JB153486/Proyecto-Balanc-n-Inteligente-II/CAD/3D/electronic/ep32 rar/6876939292.webp

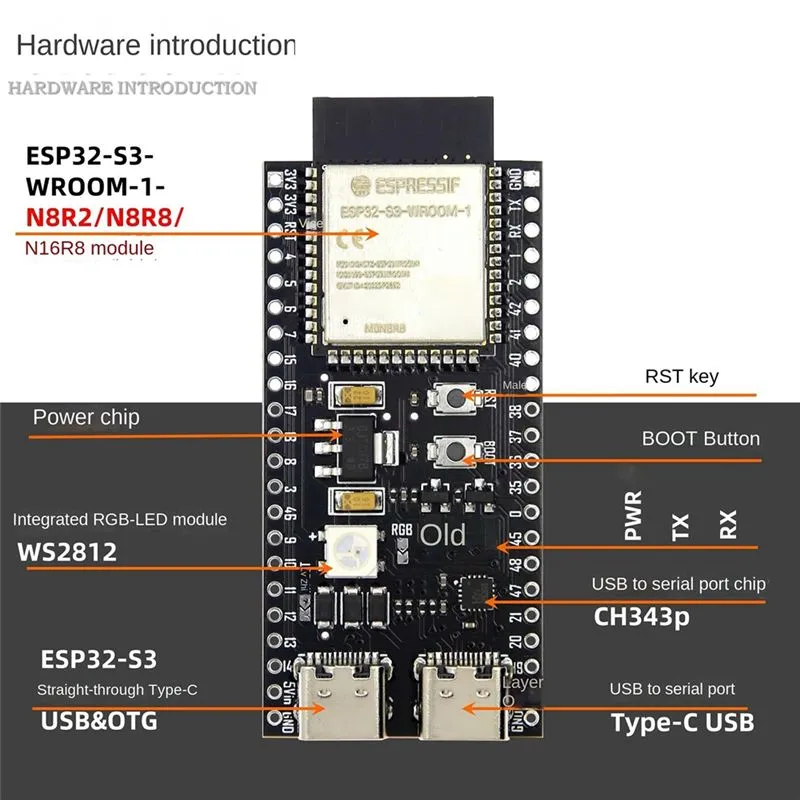
CAD/3D/electronic/ep32 rar/6876939292.webp
