JB153486/Proyecto-Balanc-n-Inteligente-II/Informe_RobotBalancin.docx

GUÍA DE PROYECTO:

DISEÑO, CONSTRUCCIÓN Y CONTROL DE UN PROTOTIPO AUTÓNOMO DE EQUILIBRIO DINÁMICO PARA SEGUIMIENTO DE TRAYECTORIA (“ROBOT SEGUIDOR BALANCÍN”)

Fase de Diseño, Construcción y Control de Equilibrio (Corte 1)

Grupo:

Rickson Alexis Hernández Jaime – 1092336882

José Daniel Barroeta Gámez – 141769323

Elkin Fabián Melo Rodríguez- 1093590111

Erley Yesid Guevara Maldonado -1092338859

Adriana Liney Florez Contreras - 1005000225

Docente:

Ing. Jeisson Martínez Flórez

Asignatura: Control Inteligente Cód. 168205

Universidad de Pamplona Facultad de Ingenierías y Arquitectura Programa de Ingeniería Mecatrónica

Villa del Rosario

TABLA DE CONTENIDO

# 1. ESPECIFICACIÓN GENERAL DEL PROYECTO

## 1.1. Resumen

El proyecto consiste en el diseño, construcción y control de un robot balancín autónomo, capaz de conservar su equilibrio dinámico mientras sigue una trayectoria determinada. El prototipo está formado por una estructura fabricada mediante impresión 3D, dos motorreductores con encoders, un sensor MPU-6050 encargado de medir la inclinación en tiempo real y un controlador ESP32-S3, que procesa la información y utiliza una estrategia de control PID para mantener la estabilidad, regulando la velocidad de los motores mediante señales PWM. El objetivo principal es conseguir que el robot mantenga el equilibrio de manera autónoma y se desplace de forma estable, demostrando la aplicación de técnicas de control automático. Entre los principales retos del proyecto se encuentran la selección de motores y materiales adecuados según las limitaciones de tamaño y peso, la calibración del sensor MPU-6050 y el ajuste manual de las constantes del PID, lo cual requirió realizar diversas pruebas hasta alcanzar una respuesta estable y precisa.

## 1.2. Objetivos Específicos.

- Investigar la variedad de componentes electrónicos y mecánicos que se pueden implementar en el robot.
- Elegir los componentes más adecuados teniendo en cuenta su disponibilidad y características técnicas.
- Diseñar la estructura física del robot y su circuito eléctrico, respetando las dimensiones establecidas.
- Implementar y ajustar el sistema de control PID mediante pruebas sucesivas hasta obtener un funcionamiento estable.

## 1.3. Alcance y Limitaciones

De acuerdo al reglamento las dimensiones de dicho robot no deben superar los 20 cm x 20 cm x 20 cm por lo que a la hora de selección de componentes y diseño del robot deben adaptarse a dicho reglamento. Además de este su peso no debe superar a 1 kilogramos, por lo que se debe tener en cuenta los pesos de los motores, llantas, batería y cuerpo, ya que son los que contienen el peso más significativo por lo que se ha mantenido en estos rangos.

# 2. ANÁLISIS DEL SISTEMA DE CONTROL DE EQUILIBRIO

Pregunta | Respuesta Detallada y Justificada
Objetivo de Control | Evitar que el robot pierda el equilibrio y caiga al suelo.
Variable Controlada | El robot controlara el ángulo de inclinación de esta misma y se estará midiendo en grados de inclinación de tal manera que el usuario pueda identificar mejor la varianza de esta.
Variable Manipulada | Para lograr el control del robot se manipulará la fuerza que ejercen cada uno de los motorreductores de acuerdo a la dirección de inclinación del robot enviándole señales en PWM.
Sensor | Se hará uso de un módulo MPU-6050 por su bajo costo y alta integración por su que combina en un solo chip un acelerómetro triaxial y un giroscopio triaxial.
Actuador | El efector final son unos Motorreductores de 12V y 100 rpm, teniendo así un buen torque para su control.
Controlador | En controlador que se estará usando es un módulo esp32 s3 N16R8, por su alto rendimiento y versatilidad, ya que integra un procesador dual-Core de 240 MHz, Wi-Fi y Bluetooth, y 16 MB de flash con 8 MB de PSRAM
Alimentación / Energía | Se utilizará una batería Litio 18650, esto para alimentar directamente los motores y con un regulador de voltaje pueda bajar el voltaje para alimentar el resto de la placa.
Interfaz Humano Máquina | El robot será programado en lenguaje C con la interfaz de IDLE de Arduino, de esta manera aplicándole su calibración automática al iniciar y empezar a controlar.
Setpoint | El setpoint será asignado directamente de la programación con la interfaz de Arduino.
Error | Con el módulo MPU detectará su ángulo en tiempo real y está comparándola con el ángulo deseado ingresado en la programación.
Rango de Operación | Se desea que el robot opere en un rango de 25 a -25 grados logrando un control efectivo.
Estrategia de Control | La estrategia de control que se implementara es control PID por medio de una librería de Arduino que ya viene integrada.

# 3. DISEÑO

## 3.1. Simulación de balancín con sus pesos

Primeramente asignamos los pesos y las dimensiones visualizados en la Ilustración 1,Ilustración 2,Ilustración 3 que nuestro Balancín tendrá para seguir con su respectiva simulación y visualizar que ubicación tiene mejores resultados el cual se vera reflejado en la Ilustración 4

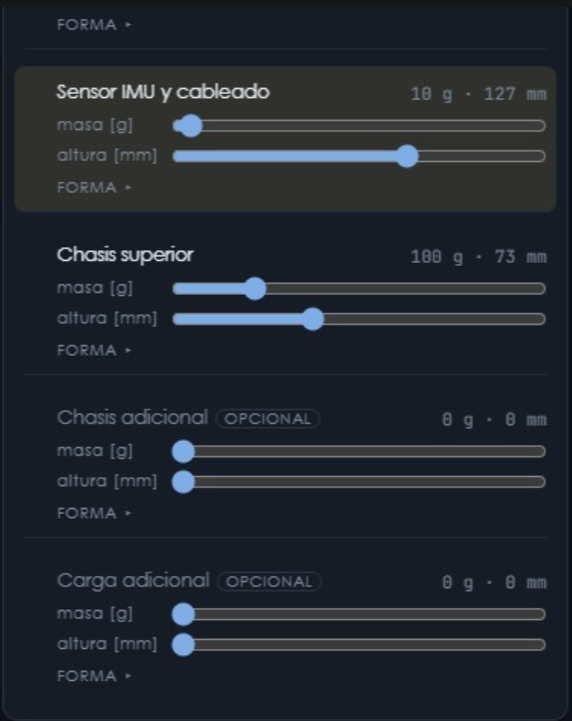
[picture p3: figure]

Ilustración 1 Simulación Dimensiones y peso Chasis

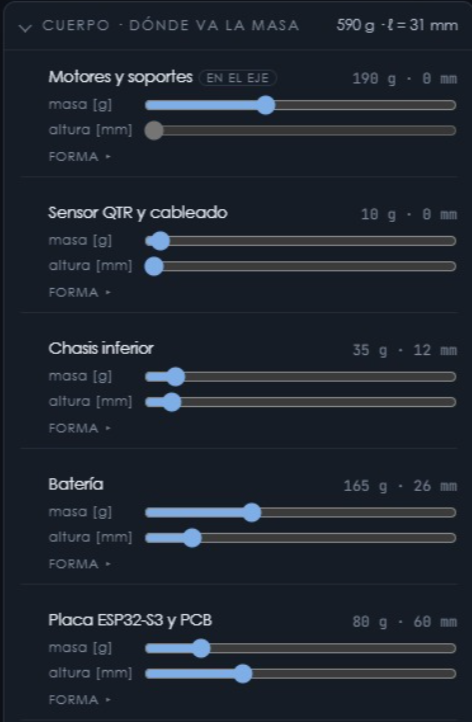
[picture p4: figure]

Ilustración 2 Simulación Cuerpo Balancín

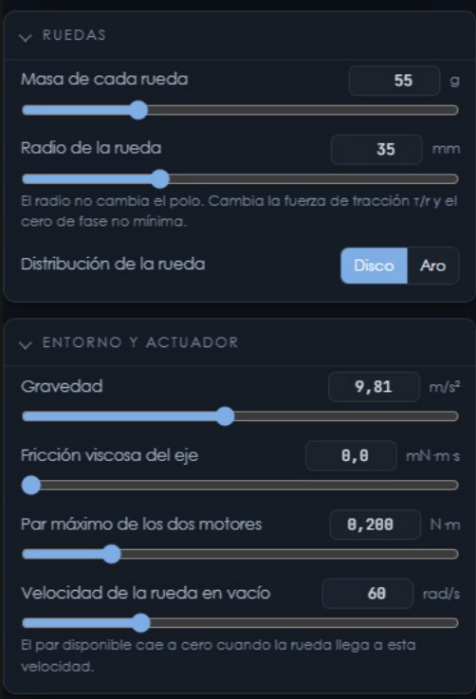
[picture p5: figure]

Ilustración 3 Simulacion zona inferior

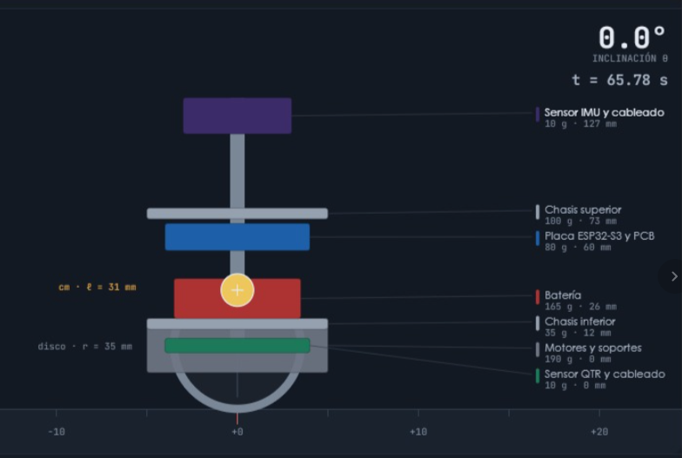
[picture p6: figure]

Ilustración 4 Visualización completa Balancín

Mayor información:

## 3.2. Diseño Mecánico CAD 3D

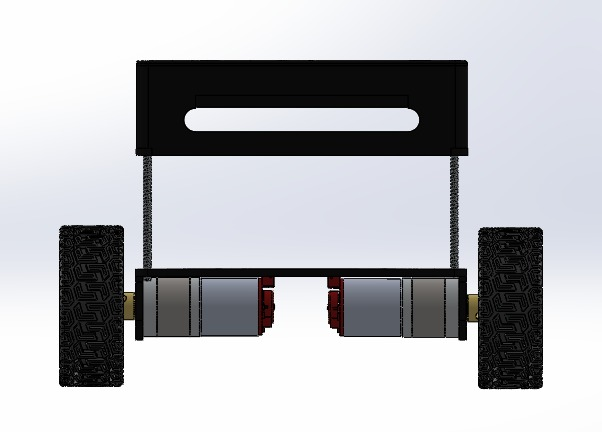
[picture p7: figure]

Ilustración 5 Ensamble del Robot

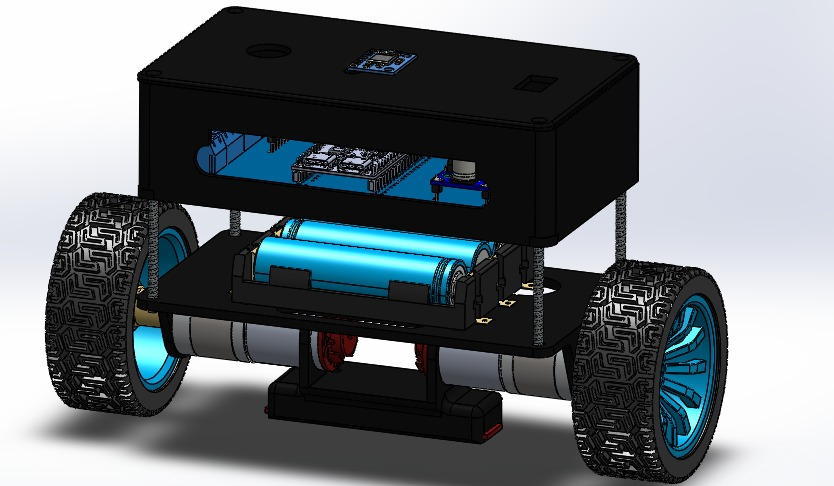
[picture p8: figure]

Ilustración 6 Diseño del robot balancín

La tapa del robot que se visualiza en la Ilustración 1 se pensó de tal manera que se instalara el MPU-6050 en todo el centro para obtener un buen rendimiento, la sección circular pensaba para agregarle un botón de inicio y la cuadrada un interruptor on/off.

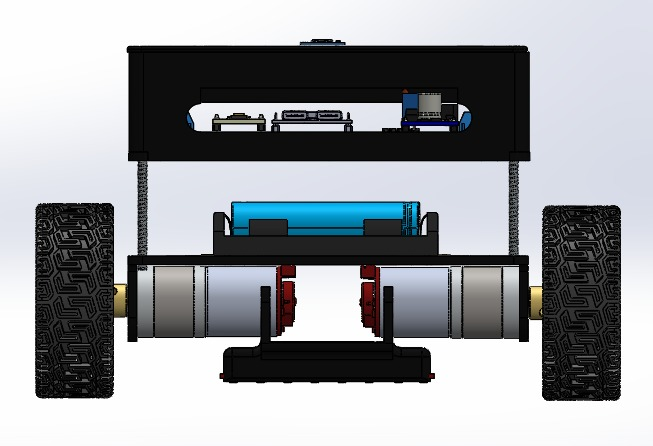
[picture p9: figure]

Ilustración 7 Visualización de las ubicaciones de componentes

En la Ilustración 3 Fue pensada para la ubicación de los módulos como el cerebro, que es la esp32, el regulador de voltaje, drivers y la placa donde ira conectada cada uno de estos módulos. La caja es pensada para que sin necesidad de extraer el esp32 pueda ser programada directamente.

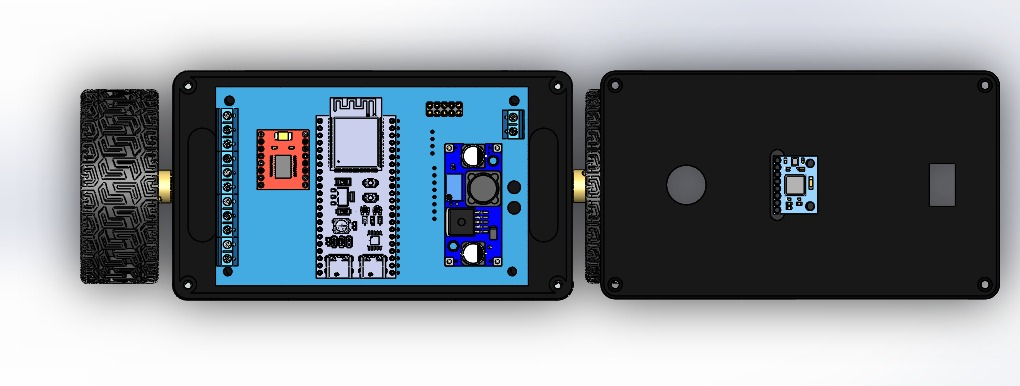
[picture p10: figure]

Ilustración 8 Parte superior

En la Ilustración 4 es pensada donde irán los implementos utilizados para este robot

Para mayor información revisa en el repositorio: https://github.com/JB153486/Proyecto-Balanc-n-Inteligente-II/tree/Rickson-Hernandez/PCB

## 3.3. Selección de Materiales

- Esp32 s3: Este controlador fue seleccionado por su alto rendimiento y versatilidad, ya que integra un procesador dual-Core de 240 MHz, Wi-Fi y Bluetooth, y 16 MB de flash con 8 MB de PSRAM, siendo esta más rápida que el Arduino Uno.

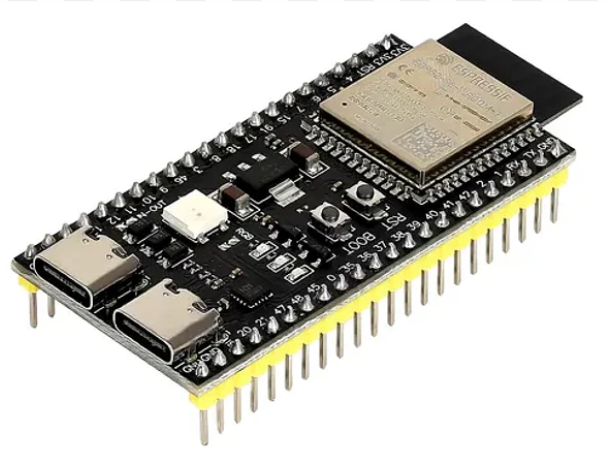
[picture p11: figure]

Motorreductor: 25GA370-12V-100RPM-ENCO es un motorreductor con encoder para generar un mayor control en el robot conociendo los pulsos generados por esta. Además, presentan un alto torque para un control más preciso.

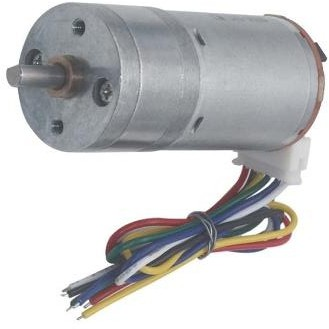
[picture p12: figure]

- Llanta de lujo: Fue seleccionado por su disponibilidad ya que esta fue adaptada con un accesorio impreso en 3D.

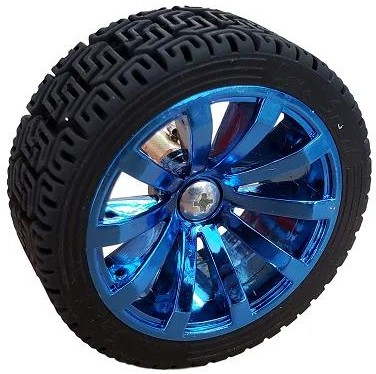
[picture p13: figure]

- Modulo MPU-6050: Este módulo se seleccionó por su bajo costo y alta integración que combina en un solo chip un acelerómetro triaxial y un giroscopio triaxial.

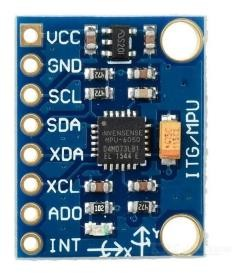
[picture p14: figure]
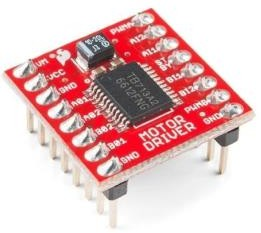
[picture p15: figure]

- TB6612FNG: Este driver tiene un pequeño tamaño y bajo costo por lo que es ideal para este diseño. Fue utilizados dos drivers para evitar sobrecalentamiento en momentos críticos.
- LM2596: Su selección es por su bajo costo y buena accesibilidad.

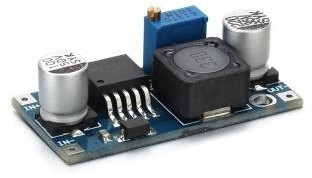
[picture p16: figure]

- Sensor seguidor de Línea 8 canales: Se selecciono por su disponibilidad.

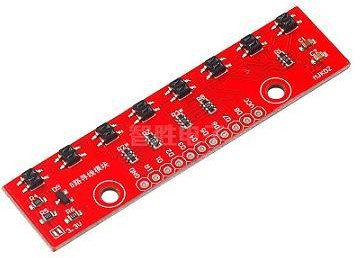
[picture p17: figure]

- PCB: Se recurrió realizar una Pcb ya que contine gran cantidad de conexiones y por el tamaño comparto del robot lo requiere.

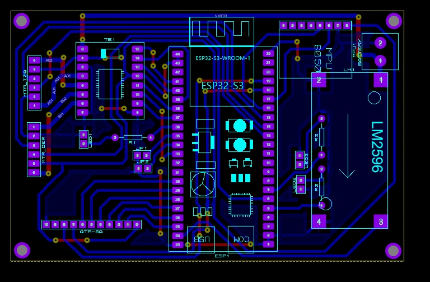
[picture p18: figure]
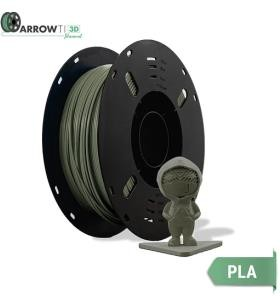
[picture p19: figure]

- PLA: Se utilizo este material ya que es ligero, cómodo y de buena durabilidad para este robot.

Otros accesorios:

- Bornes, Jumpers, conectores hembra, interruptor on/off, botón de inicio, conectores xt60, terminales, tornillos 3mm para su ensamble.

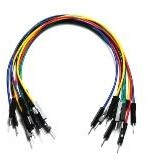
[picture p20: figure]
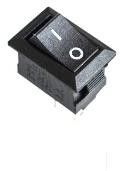
[picture p21: figure]
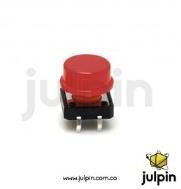
[picture p22: figure]
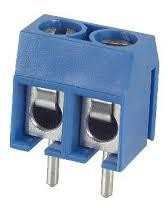
[picture p23: figure]

Puedes ver la data de cada uno aquí: https://github.com/JB153486/Proyecto-Balanc-n-Inteligente-II/tree/ElkinFabianMeloRodriguez/DATASHEETS

## 3.4. Esquema de Circuito Electrónico

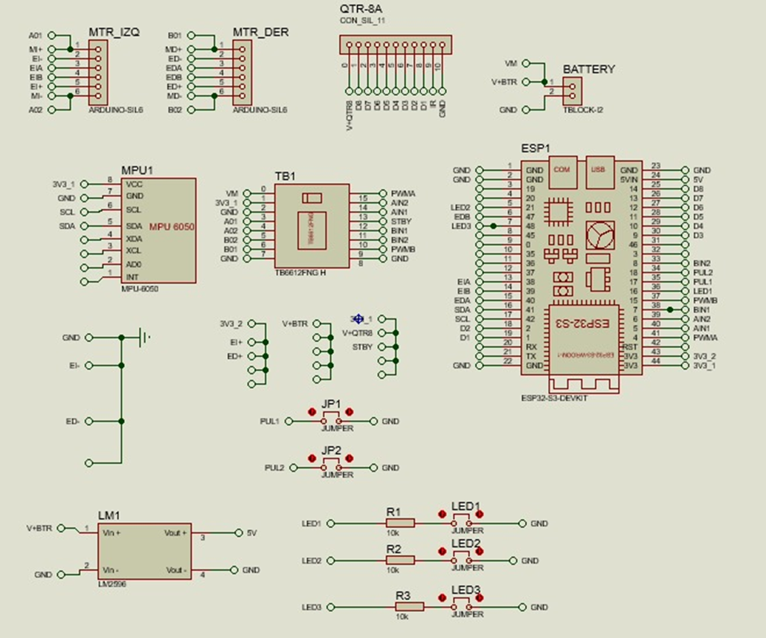
[picture p24: figure]

Ilustración 9 Circuito del robot

En la Ilustración 5 de presenta las conexiones con lo que se realizara la pcb ya que con esta ira conectada con todos los componentes del robot haciéndola más compacta.

Informacion completa de eeste en:

https://github.com/JB153486/Proyecto-Balanc-n-Inteligente-II/tree/Rickson-Hernandez/PCB

## 3.5. Estimación de costos

Componente/Material | Cantidad | Costo Unitario (COP) | Costo Total (COP)
Esp 32 S3 | 1 | $90.000 | $90.000
Motorreductor con encoder 12v 100rpm | 2 | $37.500 | $75.000
Llantas de lujo | 2 | $20.000 | $40.000
Modulo MPU-6050 | 1 | $18.000 | $18.000
Driver TB6612FNG | 2 | $15.000 | $15.000
Fuente suichieada variable LM2596 | 1 | $5.000 | $5.000
Sensor seguidor de línea-8 canales | 1 | $10.000 | $10.000
Bornera | 1 | $1.000 | $1.000
tornilleria | 16 | $400-1000 | $6.000
jumpers | 20 | $20 | $4.000
Plaqueta de cobre | 1 | $30.000 | $30.000
Impresión 3D | | $74.000 | $74.000
Costo de transporte | 1 | $10.000 | $10.000
Total | | | $378.000

# 4. CONSTRUCCIÓN

"En primer lugar, se llevó a cabo una investigación exhaustiva de los componentes aptos para este tipo de plataformas robóticas. Este proceso se apoyó en material audiovisual, literatura web y herramientas de inteligencia artificial con el fin de evaluar alternativas viables en función de su disponibilidad, costo y compatibilidad técnica.

Ya con esto se hizo la compra de los componentes necesarios a utilizar, se hizo su respectivo diseño en cad 3d, se hizo las conexiones necesarias en proteus y se empezó a diseñar en físico y a hacer las pruebas unitarias de este.

Después de dicha selección gracias al conocimiento adquirido de los videos se recurrió a realizar el diseño base del robot en el que se inspiró en la Ilustración 6, quedando un resultado como se logra visualizar en la Ilustración 7 .

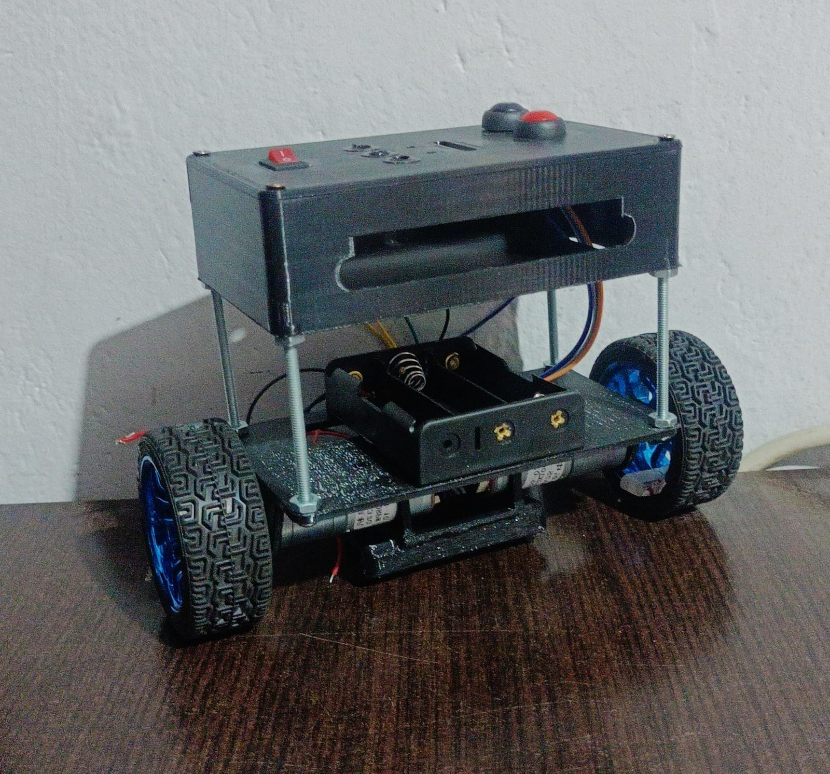
[picture p25: figure]

Ilustración 10 Robot Balancín

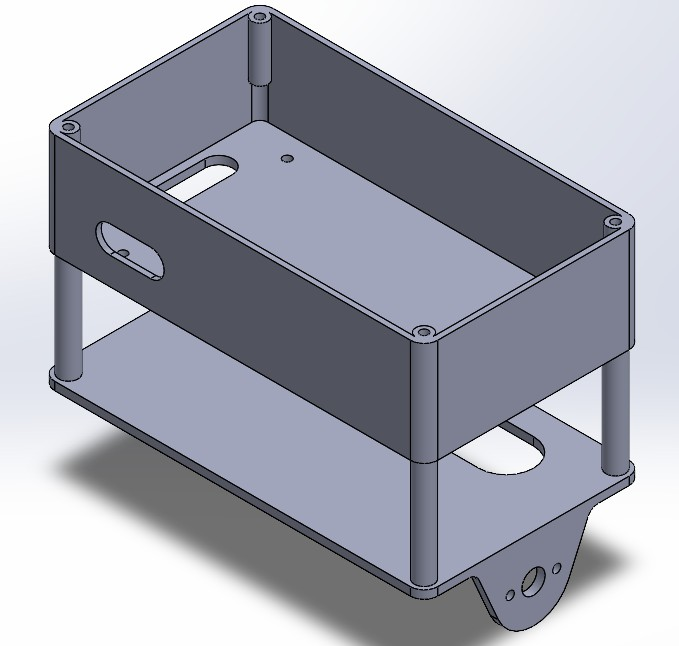
[picture p26: figure]

Ilustración 11 Diseño 3D pieza

En un principio se pensó Hacer la impresión en una sola pieza, pero se encontraba el problema que por el tamaño del robot a la hora de imprimir dificultaba a la impresora 3D y se gastaría material innecesario en soportes para su impresión. Entonces para más practicidad se decidió dividir en dos partes el diseño y conectarlas con tornillos de 4mm se son sencillos de conseguir, ya que al querer conseguir tornillos de expansión no había disponibilidad en la ciudad y el costo de importación no se justificaba.

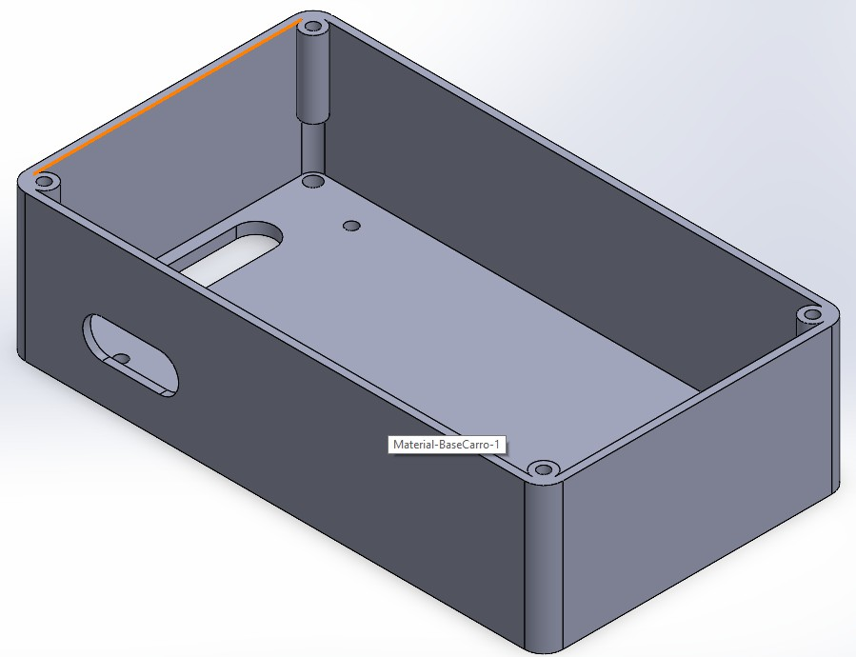
[picture p27: figure]

Ilustración 12 Pieza 1 del diseño del Robot

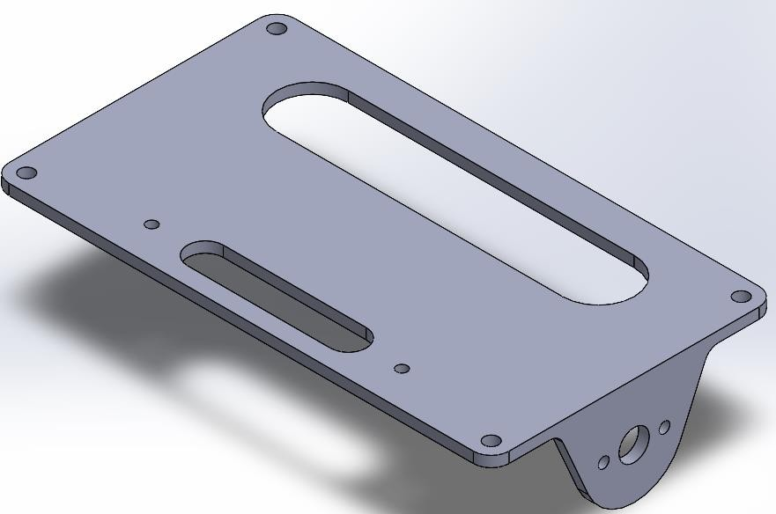
[picture p28: figure]

Ilustración 13 Pieza 2 del diseño del Robot

También se realizó el diseño de la tapa donde irían ubicado el MPU-6050 y los botones.

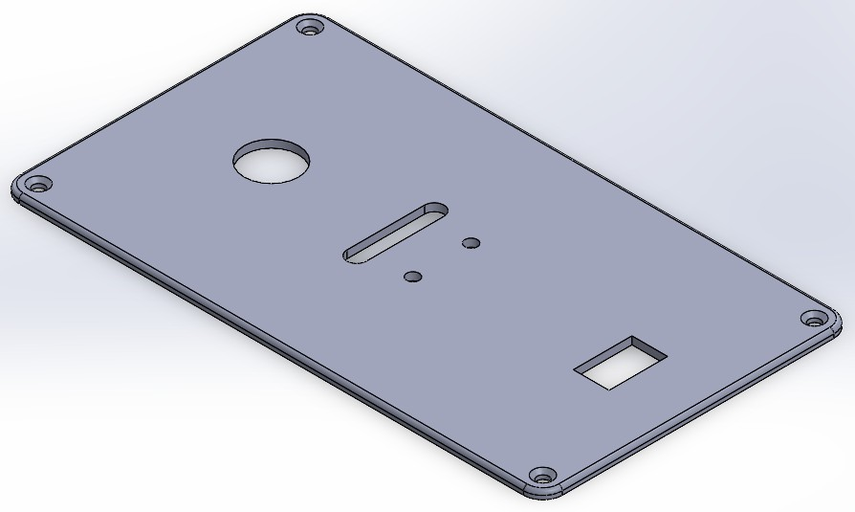
[picture p29: figure]

Ilustración 14 Tapa del Robot

Teniendo el Diseño ya establecido y con la llegada de los componentes como siguiente paso se realizó pruebas independientes tanto al MPU-6050 y el Driver TB6612FNG como se logra visualizar en la Ilustración 11 e Ilustración 12

Informacion comleta en: https://github.com/JB153486/Proyecto-Balanc-n-Inteligente-II/tree/Rickson-Hernandez/PCB

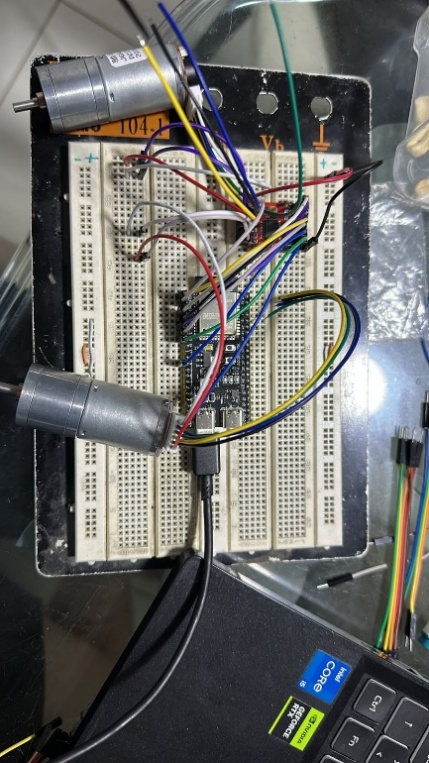
[picture p30: figure]

Ilustración 15 Pruebas unitarias en motores encoders

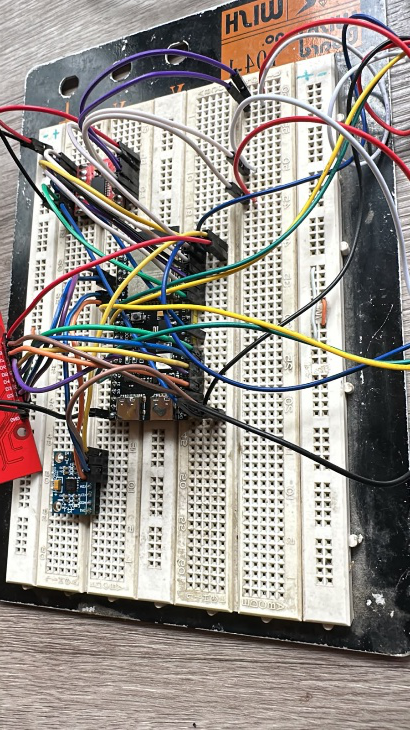
[picture p31: figure]

Ilustración 16 Pruebas unitarias en puente H, MPU y sensor de línea

Ya comprobando el funcionamiento de los componentes recurrimos a realizar la programación integrando las librerías del PID para realizar su primera prueba en protoboard y así diseñar su PCB.

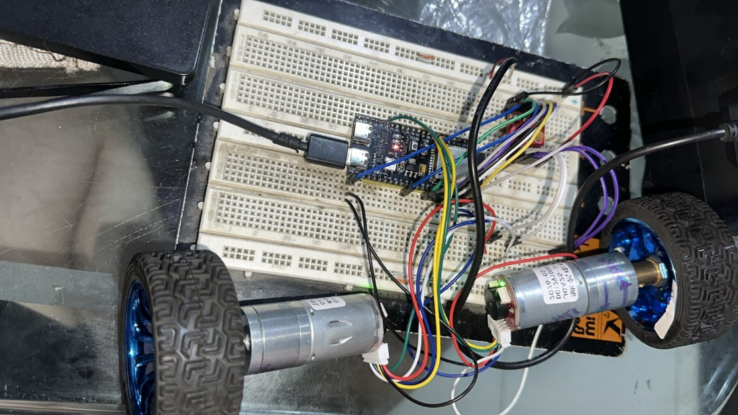
[picture p32: figure]

Ilustración 17 Prueba de conexión con Programación PID

Informacion completa de las pruebas:

https://github.com/JB153486/Proyecto-Balanc-n-Inteligente-II/tree/ElkinFabianMeloRodriguez/PruebasUnitarias

Por otro lado, se realizó la construcción física del robot sin sus módulos para evaluar sus dimensiones y estética del robot dando un buen aspecto constructivo.

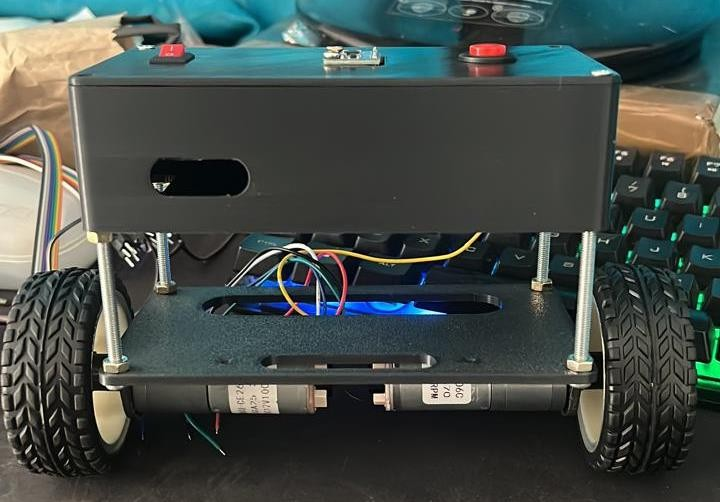
[picture p33: figure]

Ilustración 18 Ensamble físico del Robot

Como primera prueba del código dio una respuesta positiva, por lo que se recurrió a avanzar al siguiente paso que es el diseñado de la PCB iniciando suministrándoles sus conexiones incluyendo botones y borneras.

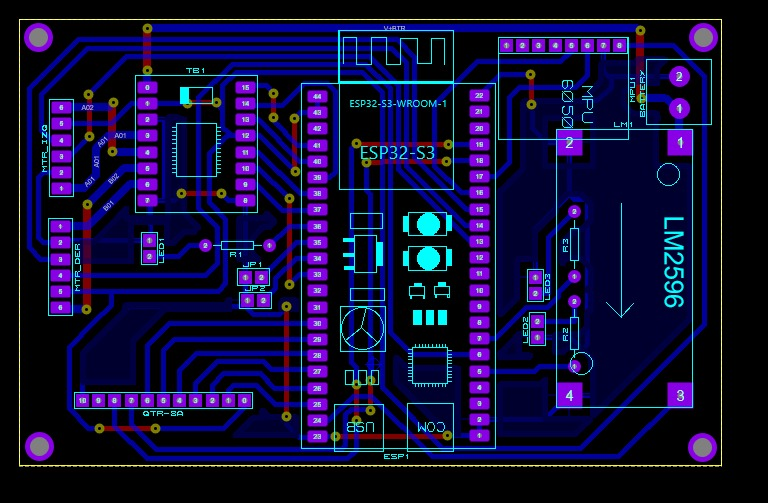
[picture p34: figure]

Ilustración 19 Diseño PCB en Proteus

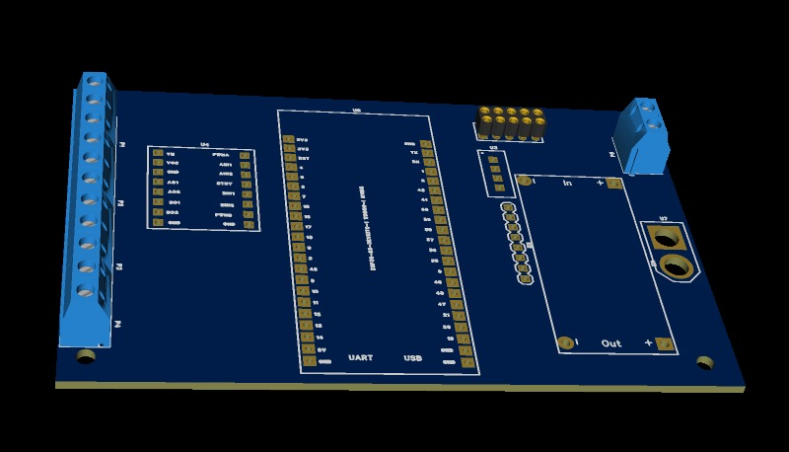
[picture p35: figure]

Ilustración 20 PCB simulada en 3D

Teniendo el deseño simulado en proteus y listo, procedemos a realizarlo en físico quedando de la siguiente manera

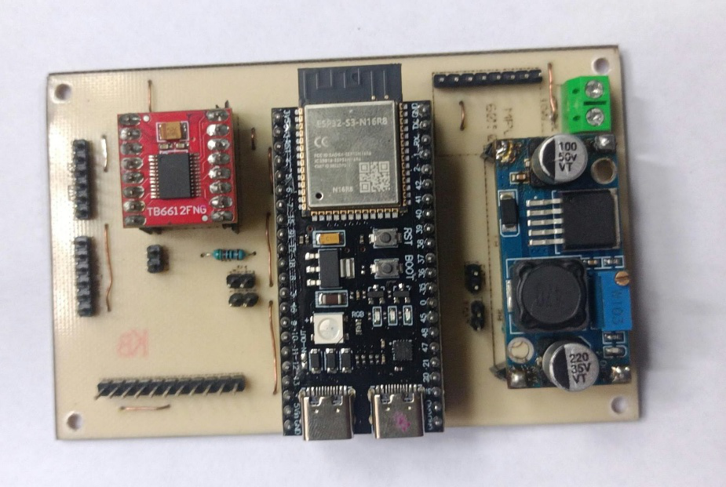
[picture p36: figure]

Ilustración 21 Placa Física del Robot

Informacion completa en: https://github.com/JB153486/Proyecto-Balanc-n-Inteligente-II/tree/Rickson-Hernandez/PCB

  4.1. Conexiones de cada componente

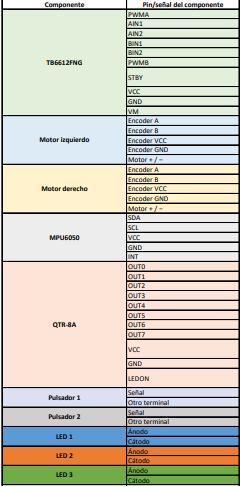
[picture p37: figure]
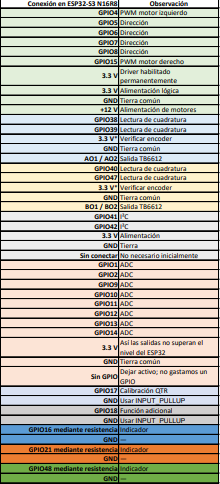
[picture p38: figure]

Ilustración 22 Conexiones componente a componente

En esta ilustración podemos encontrar las conexiones de cada componente en donde podemos encontrar el pin al que es conectado cada componente , las conexiones de la Esp32-s3 y tenemos una pequeña definición de que sería cada pin.

Mayor información: https://github.com/JB153486/Proyecto-Balanc-n-Inteligente-II/blob/ElkinFabianMeloRodriguez/CONEXIONES/Componente.pdf

# 5. PRUEBAS DE PROTOTIPO PARA EL EQUILIBRIO

Código pruebas equilibrio

// ============================================================

// INTEGRACIÓN IMU + ENCODERS + MOTORES

// CONTROL DE EQUILIBRIO - PASO 3: PD DE ÁNGULO (RUEDAS AL AIRE)

// ============================================================

#include "imu.h"

#include "encoders.h"

#include "motores.h"

#include "equilibrio.h"

#include "wifi_manager.h"

#include "telemetry.h"

#include "comandos.h"

#include "web_server.h"

// ============================================================

// PINES DE BOTONES Y LEDS (Según conection.xlsx)

// ============================================================

const int BOTON_QTR = 17; // Pulsador 1 (Calibración QTR)

const int BOTON_INICIO = 18; // Pulsador 2 (Iniciar balanceo y vel)

const int LED_POWER = 16; // LED 1 (Encendido)

const int LED_ACTIVO = 21; // LED 2 (Robot balanceando)

const int LED_QTR = 48; // LED 3 (Futuro QTR)

unsigned long ultimoTiempoBtn1 = 0;

unsigned long ultimoTiempoBtn2 = 0;

bool estadoAnteriorBtn1 = HIGH;

bool estadoAnteriorBtn2 = HIGH;

const unsigned long tiempoRebote = 200; // ms

// ============================================================

// TEMPORIZACIÓN DEL CONTROL

// ============================================================

// Periodo de control de 10 ms.

// Equivale a 100 Hz.

const unsigned long CONTROL_PERIOD_US = 10000;

// Tiempo de la última actualización.

unsigned long previousControlTime = 0;

// ---- BASELINE TEMPORAL (se quita después) ----

uint32_t bsT0 = 0, bsTicks = 0, bsLoops = 0;

float bsSum = 0, bsMin = 1e9f, bsMax = 0;

// ============================================================

// PARÁMETROS DE SEGURIDAD Y MOTORES

// ============================================================

// Si el robot supera este ángulo, los motores se cortan.

// Con las ruedas al aire usamos 60 grados.

// En el piso lo bajaremos a unos 30-35 grados.

const float ANGULO_CORTE = 50.0;

// Zona muerta de cada motor (PWM mínimo medido + pequeño margen).

const int ZM_L = 12; // izquierdo (medido 10-11)

const int ZM_R = 12; // derecho (medido 9-10)

// Los motores arrancan desarmados.

// Se arman por Serial con el comando e1.

bool habilitado = false;

unsigned long armandoHasta = 0; // 0 = sin cuenta regresiva

// ---- PI DE VELOCIDAD (lazo externo) ----

// (velKp, velKi, velIntegral, velDeseada y velActivo ahora están en comandos.h)

const float RADIO_RUEDA = 0.035f; // m

const float OFFSET_MAX = 20.0f; // grados máximos que puede mover el setpoint

float velKp = 42.0f;

// ============================================================

// COMPENSACIÓN DE ZONA MUERTA

// ============================================================

// Convierte la salida del controlador u (rango +-EQUILIBRIO_OUTPUT_LIMIT)

// en un PWM que ya supera la zona muerta del motor.

int compensarZonaMuerta(float u, int zm)

{

if (fabsf(u) < 0.5f)

{

return 0;

}

float mag = zm + (fabsf(u) / EQUILIBRIO_OUTPUT_LIMIT) * (255 - zm);

return (u > 0) ? (int)mag : -(int)mag;

}

// ============================================================

// COMANDOS POR SERIAL

//

// p10 -> Kp = 10

// d0.3 -> Kd = 0.3

// i0 -> Ki = 0

// t0.8 -> setpoint (punto de equilibrio) = 0.8 grados

// e1 -> armar motores

// e0 -> parar motores

//

// El Monitor Serial debe enviar "Nueva línea" o "Ambos NL & CR".

// ============================================================

void enviarRespuesta(uint32_t id, bool ok, const char *msg)

{

if (!colaResp || !telClientes) return;

Respuesta r = { id, (uint8_t)ok, "", equilibrioKp, equilibrioKi, equilibrioKd, equilibrioSetpoint,

velKp, velKi, velDeseada, (uint8_t)velActivo };

strncpy(r.msg, msg, sizeof(r.msg) - 1);

xQueueSend(colaResp, &r, 0);

}

void procesarComandos()

{

// 1) La parada de emergencia tiene prioridad sobre todo.

if (paroSolicitado)

{

habilitado = false;

armandoHasta = 0;

motoresStop();

equilibrioReset();

paroSolicitado = false;

enviarRespuesta(paroId, true, "");

}

// 2) Resto de comandos: este es el único lugar que escribe las variables.

Comando c;

while (colaCmd && xQueueReceive(colaCmd, &c, 0) == pdTRUE)

{

if (c.tipo == CMD_PARAMS)

{

equilibrioKp = c.kp; equilibrioKi = c.ki;

equilibrioKd = c.kd; equilibrioSetpoint = c.sp;

enviarRespuesta(c.id, true, "");

}

else if (c.tipo == CMD_VEL) // <-- NUEVA

{

velKp = c.vkp; velKi = c.vki;

if (c.vact && !velActivo) velIntegral = 0;

velActivo = c.vact;

velDeseada = (c.vact && habilitado) ? c.vref : 0;

enviarRespuesta(c.id, true, "");

}

else if (!c.on)

{

habilitado = false;

armandoHasta = 0;

motoresStop();

equilibrioReset();

enviarRespuesta(c.id, true, "");

}

else if (fabsf(imuGetAngleRobot()) >= ANGULO_CORTE)

{

enviarRespuesta(c.id, false, "Inclinacion excesiva");

}

else

{

armandoHasta = millis() + ARM_ESPERA_MS;

enviarRespuesta(c.id, true, "");

}

}

// 3) Fin de la cuenta regresiva: arma solo si el robot sigue en rango.

if (armandoHasta && (long)(millis() - armandoHasta) >= 0)

{

armandoHasta = 0;

if (fabsf(imuGetAngleRobot()) < ANGULO_CORTE)

{

equilibrioReset();

habilitado = true;

}

}

}

void procesarSerial()

{

if (!Serial.available())

{

return;

}

char c = Serial.read();

if (c == '\n' || c == '\r' || c == ' ')

{

return;

}

float v = Serial.parseFloat();

switch (c)

{

case 'p': if (v >= 0 && v <= LIM_KP_MAX) equilibrioKp = v; break;

case 'd': if (v >= 0 && v <= LIM_KD_MAX) equilibrioKd = v; break;

case 'i': if (v >= 0 && v <= LIM_KI_MAX) equilibrioKi = v; break;

case 't': if (fabsf(v) <= LIM_SP_MAX) equilibrioSetpoint = v; break;

case 'v': if (v >= 0 && v <= LIM_VKP_MAX) velKp = v; break; // v4

case 'w': if (v >= 0 && v <= LIM_VKI_MAX) velKi = v; break; // w1

case 'r': if (fabsf(v) <= LIM_VREF_MAX && habilitado) velDeseada = v; break; // r0.2

case 'y': velActivo = (v != 0); velIntegral = 0; break; // y1 / y0

case 'e':

habilitado = (v != 0);

armandoHasta = 0;

equilibrioReset();

break;

}

if ((c == 'p' && (v < 0 || v > LIM_KP_MAX)) ||

(c == 'd' && (v < 0 || v > LIM_KD_MAX)) ||

(c == 'i' && (v < 0 || v > LIM_KI_MAX)) ||

(c == 't' && fabsf(v) > LIM_SP_MAX))

{

Serial.println("Valor fuera de rango: ignorado");

}

Serial.printf("Kp=%.2f Kd=%.2f Ki=%.2f Set=%.2f En=%d\n",

equilibrioKp, equilibrioKd, equilibrioKi,

equilibrioSetpoint, habilitado);

}

// ============================================================

// SETUP

// ============================================================

void setup()

{

// --------------------------------------------------------

// SERIAL

// --------------------------------------------------------

Serial.begin(115200);

// --- INICIALIZAR BOTONES Y LEDS ---

pinMode(BOTON_QTR, INPUT_PULLUP);

pinMode(BOTON_INICIO, INPUT_PULLUP);

pinMode(LED_POWER, OUTPUT);

pinMode(LED_ACTIVO, OUTPUT);

pinMode(LED_QTR, OUTPUT);

// Encender el LED de Power para indicar que la ESP32 inició

digitalWrite(LED_POWER, HIGH);

// Apagar los otros dos LEDs temporalmente

digitalWrite(LED_ACTIVO, LOW);

digitalWrite(LED_QTR, LOW);

// Evita que parseFloat() bloquee el lazo de control.

Serial.setTimeout(10);

// Esperamos al monitor serial.

delay(1500);

Serial.println();

Serial.println("======================================");

Serial.println(" INTEGRACION CONTROL EQUILIBRIO");

Serial.println("======================================");

// --------------------------------------------------------

// MOTORES

// --------------------------------------------------------

// Inicializamos el controlador de motores.

motoresBegin();

// Por seguridad, los dejamos detenidos.

motoresStop();

// --------------------------------------------------------

// ENCODERS

// --------------------------------------------------------

// Inicializamos los dos encoders.

setupEncoders();

// --------------------------------------------------------

// IMU

// --------------------------------------------------------

Serial.println("Inicializando MPU6050...");

// Inicializamos el IMU.

if (!imuBegin())

{

Serial.println("ERROR: MPU6050 no encontrado.");

// Si no existe IMU, detenemos el programa.

motoresStop();

while (true)

{

delay(1000);

}

}

// --------------------------------------------------------

// CALIBRACIÓN DEL GIROSCOPIO

// --------------------------------------------------------

Serial.println();

Serial.println("Mantener robot quieto.");

Serial.println("Iniciando calibracion...");

imuCalibrateGyro();

if (wifiBegin())

{

Serial.print("WiFi AP listo: ");

Serial.println(WiFi.softAPIP());

telemetriaInit();

comandosInit();

wsBegin();

}

else

{

Serial.println("ERROR: no se pudo iniciar el AP.");

}

// --------------------------------------------------------

// REINICIAR TEMPORIZACIÓN DEL IMU

// --------------------------------------------------------

imuResetTiming();

// --------------------------------------------------------

// CONTROL DE EQUILIBRIO

// --------------------------------------------------------

equilibrioBegin();

// --------------------------------------------------------

// TIEMPO DEL CONTROL

// --------------------------------------------------------

previousControlTime = micros();

bsT0 = millis();

Serial.println();

Serial.println("Sistema listo.");

Serial.println("Motores detenidos.");

Serial.println("Comandos: p<Kp> d<Kd> i<Ki> t<setpoint> e1/e0");

Serial.println();

}

void procesarBotones()

{

unsigned long tiempoActual = millis();

// Leemos cómo están los botones en este exacto milisegundo

bool estadoActualBtn2 = digitalRead(BOTON_INICIO);

bool estadoActualBtn1 = digitalRead(BOTON_QTR);

// 1) BOTÓN 2 (Inicio/Parada de Balanceo)

// Solo actúa si AHORA está presionado (LOW) y ANTES estaba suelto (HIGH)

if (estadoActualBtn2 == LOW && estadoAnteriorBtn2 == HIGH && (tiempoActual - ultimoTiempoBtn2 > tiempoRebote))

{

ultimoTiempoBtn2 = tiempoActual;

if (!habilitado) {

if (fabsf(imuGetAngleRobot()) < ANGULO_CORTE) {

equilibrioReset();

velIntegral = 0;

habilitado = true;

velActivo = true;

velDeseada = 0.0f;

Serial.println("▶ BOTON: Lazos ACTIVADOS");

} else {

Serial.println("⚠ BOTON: No se puede activar, el robot esta muy inclinado");

}

} else {

habilitado = false;

velActivo = false;

motoresStop();

equilibrioReset();

Serial.println("⏹ BOTON: Lazos DESACTIVADOS");

}

}

estadoAnteriorBtn2 = estadoActualBtn2; // Guardamos la foto del estado para el siguiente ciclo

// 2) BOTÓN 1 (Futura calibración de línea)

if (estadoActualBtn1 == LOW && estadoAnteriorBtn1 == HIGH && (tiempoActual - ultimoTiempoBtn1 > tiempoRebote))

{

ultimoTiempoBtn1 = tiempoActual;

digitalWrite(LED_QTR, !digitalRead(LED_QTR));

Serial.println("⚙ BOTON: Calibracion QTR presionado");

}

estadoAnteriorBtn1 = estadoActualBtn1;

// 3) ACTUALIZAR LEDS DE ESTADO

if (habilitado) {

digitalWrite(LED_ACTIVO, HIGH);

} else {

digitalWrite(LED_ACTIVO, LOW);

}

}

// ============================================================

// LOOP

// ============================================================

void loop()

{

bsLoops++;

// --------------------------------------------------------

// ACTUALIZAR IMU

// --------------------------------------------------------

imuUpdate();

// --------------------------------------------------------

// ACTUALIZAR ENCODERS

// --------------------------------------------------------

updateEncoders();

// --------------------------------------------------------

// COMANDOS POR SERIAL

// --------------------------------------------------------

procesarSerial();

procesarComandos();

procesarBotones(); // <--- AGREGA ESTA LÍNEA AQUÍ

// --------------------------------------------------------

// CONTROL A 100 Hz

// --------------------------------------------------------

unsigned long currentTime = micros();

unsigned long elapsedTime =

currentTime - previousControlTime;

if (elapsedTime >= CONTROL_PERIOD_US)

{

// Convertimos microsegundos a segundos.

float dt =

elapsedTime / 1000000.0;

// Guardamos el tiempo.

previousControlTime =

currentTime;

// ---- BASELINE TEMPORAL ----

float dtMs = dt * 1000.0f;

bsSum += dtMs; bsTicks++;

if (dtMs < bsMin) bsMin = dtMs;

if (dtMs > bsMax) bsMax = dtMs;

uint32_t ahora = millis();

if (ahora - bsT0 >= 2000) {

Serial.printf("BASE dt[ms] prom=%.2f min=%.2f max=%.2f ticks=%lu loop/s=%lu\n",

bsSum / bsTicks, bsMin, bsMax, (unsigned long)bsTicks,

(unsigned long)(bsLoops * 1000UL / (ahora - bsT0)));

bsSum = 0; bsTicks = 0; bsLoops = 0; bsMin = 1e9f; bsMax = 0; bsT0 = ahora;

}

/*

// ----------------------------------------------------

// ÁNGULO Y VELOCIDAD ANGULAR

// ----------------------------------------------------

float angulo = imuGetAngleRobot(); // grados

float velAng = imuGetGyroRateRobot(); // grados/s

// ---- PI DE VELOCIDAD ----

float vMedida = 0.5f * (getEncoderRadPerSecondFilteredLeft() +

getEncoderRadPerSecondFilteredRight()) * RADIO_RUEDA;

if (velActivo && habilitado)

{

float eV = velDeseada - vMedida;

velIntegral += eV * dt; // no acumula durante una caída

velIntegral = constrain(velIntegral, -OFFSET_MAX / max(velKi, 0.01f),

OFFSET_MAX / max(velKi, 0.01f));

equilibrioOffset = constrain(velKp * eV + velKi * velIntegral,

-OFFSET_MAX, OFFSET_MAX);

}

else

{

velIntegral = 0.0f;

equilibrioOffset = 0.0f;

if (!habilitado) velDeseada = 0.0f; // <-- NUEVA

}

*/

// ----------------------------------------------------

// ÁNGULO Y VELOCIDAD ANGULAR

// ----------------------------------------------------

float angulo = imuGetAngleRobot(); // grados

float velAng = imuGetGyroRateRobot(); // grados/s

// ---- CÁLCULO DE VELOCIDAD (100 Hz para telemetría) ----

float vMedida = 0.5f * (getEncoderRadPerSecondFilteredLeft() +

getEncoderRadPerSecondFilteredRight()) * RADIO_RUEDA;

// ---- PI DE VELOCIDAD (Aislado a 20 Hz) ----

static int contadorVelocidad = 0;

contadorVelocidad++;

if (contadorVelocidad >= 5)

{

contadorVelocidad = 0; // Reiniciamos el contador

if (velActivo && habilitado)

{

float eV = velDeseada - vMedida;

// dt para velocidad ahora es 5 veces mayor (0.05s)

float dt_vel = dt * 5.0f;

velIntegral += eV * dt_vel; // Integración corregida

velIntegral = constrain(velIntegral, -OFFSET_MAX / max(velKi, 0.01f),

OFFSET_MAX / max(velKi, 0.01f));

equilibrioOffset = constrain(velKp * eV + velKi * velIntegral,

-OFFSET_MAX, OFFSET_MAX);

}

else

{

velIntegral = 0.0f;

equilibrioOffset = 0.0f;

if (!habilitado) velDeseada = 0.0f;

}

}

// ----------------------------------------------------

// CONTROL DE EQUILIBRIO (PD)

// ----------------------------------------------------

float correccion =

equilibrioUpdate(angulo, velAng, dt);

// ----------------------------------------------------

// SIGNO

//

// error = setpoint - angulo, así que con el robot

// inclinado hacia adelante (angulo > 0) la corrección

// sale negativa. Las ruedas deben ir hacia adelante,

// por eso invertimos el signo.

// ----------------------------------------------------

float u = -correccion;

// ----------------------------------------------------

// ENVIAR A LOS MOTORES

// ----------------------------------------------------

if (habilitado && fabsf(angulo) < ANGULO_CORTE)

{

motoresSet(

compensarZonaMuerta(u, ZM_L),

compensarZonaMuerta(u, ZM_R));

}

else

{

motoresStop();

equilibrioReset();

// Si se cayó, queda desarmado hasta enviar e1.

if (fabsf(angulo) >= ANGULO_CORTE)

{

habilitado = false;

}

}

// ---- TELEMETRÍA ----

static float hzFiltrado = 95.0f;

hzFiltrado += 0.1f * ((1.0f / dt) - hzFiltrado);

if (telClientes)

{

long resta = armandoHasta ? (long)(armandoHasta - millis()) : 0;

MuestraTel tel = {

millis(), angulo, equilibrioSetpoint, (equilibrioSetpoint + equilibrioOffset) - angulo,

velAng, u,

(int16_t)motoresGetLeftPWM(), (int16_t)motoresGetRightPWM(),

getEncoderRPMFilteredLeft(), getEncoderRPMFilteredRight(),

hzFiltrado,

(uint8_t)(habilitado ? 1 : (armandoHasta ? 2 : 0)),

(uint8_t)(resta > 0 ? (resta + 999) / 1000 : 0) ,

vMedida, velDeseada, equilibrioOffset, (uint8_t)velActivo };

telemetriaPublicar(tel);

}

// ----------------------------------------------------

// MONITOR SERIAL

// ----------------------------------------------------

static uint8_t n = 0;

if (++n >= 5) // imprime cada 50 ms

{

n = 0;

Serial.printf("Robot:%.1f,U:%.0f,En:%d,V:%.2f,Off:%.2f\n",

angulo, u, habilitado, vMedida, equilibrioOffset);

}

}

}

Mayor información de cada función: https://github.com/JB153486/Proyecto-Balanc-n-Inteligente-II/tree/Jos%C3%A9-Barroeta/Control_Equilibrio/Control_Equilibrio

# 6. REFERENCIAS

https://category.yahboom.net/es/products/sbr-stm32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 (https://category.yahboom.net/es/products/sbr-stm32)

Inteligencia artificial como apoyo(chat gpt, Gemini) https://docs.arduino.cc/libraries/mpu6050/

https://www.automatizacionparatodos.com/puente-h-arduino/

https://docs.arduino.cc/libraries/pid/

Plantilla de Entrega Asignación Fase 1 (Corte 1) Control Inteligente 168205 2026-2 Código: FGA-XXXX Página 1 de 25

Plantilla de Entrega Asignación Fase 1 (Corte 1) Control Inteligente 168205 2025-2 Código: FGA-XXXX Página 17 de 25

Plantilla de Entrega Asignación Fase 1 (Corte 1) Control Inteligente 168205 2026-2 Código: FGA-XXXX Página 18 de 25

Plantilla de Entrega Asignación Fase 1 (Corte 1) Control Inteligente 168205 2026-2 Código: FGA-XXXX Página 25 de 25

Plantilla de Entrega Asignación Fase 1 (Corte 1) Control Inteligente 168205 2026-2 Código: FGA-XXXX Página 2 de 25

Plantilla de Entrega Asignación Fase 1 (Corte 1) Control Inteligente 168205 2026-2 Código: FGA-XXXX Página 3 de 25

Plantilla de Entrega Asignación Fase 1 (Corte 1) Control Inteligente 168205 2026-2 Código: FGA-XXXX Página 4 de 25

Plantilla de Entrega Asignación Fase 1 (Corte 1) Control Inteligente 168205 2026-2 Código: FGA-XXXX Página 5 de 25

Plantilla de Entrega Asignación Fase 1 (Corte 1) Control Inteligente 168205 2026-2 Código: FGA-XXXX Página 9 de 25

Plantilla de Entrega Asignación Fase 1 (Corte 1) Control Inteligente 168205 2026-2 Código: FGA-XXXX Página 10 de 25

Plantilla de Entrega Asignación Fase 1 (Corte 1) Control Inteligente 168205 2026-2 Código: FGA-XXXX Página 15 de 25

Plantilla de Entrega Asignación Fase 1 (Corte 1) Control Inteligente 168205 2026-2 Código: FGA-XXXX Página 16 de 25
