JB153486/Proyecto-Balanc-n-Inteligente-II/CAD/3D/electronic/ep32 rar/00.jpg

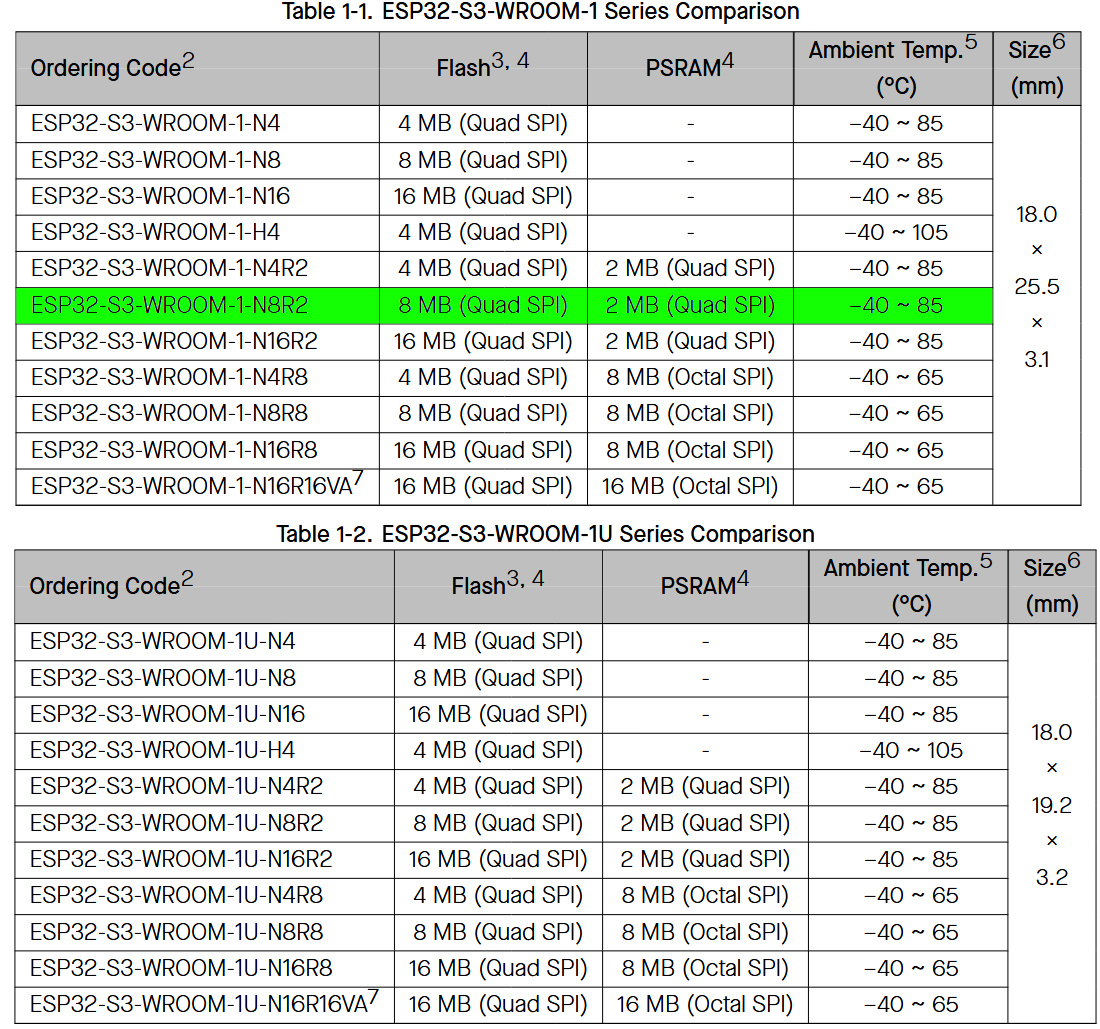
CAD/3D/electronic/ep32 rar/00.jpg
