JB153486/Proyecto-Balanc-n-Inteligente-II/CAD/3D/electronic/ep32 rar/6879005999.webp

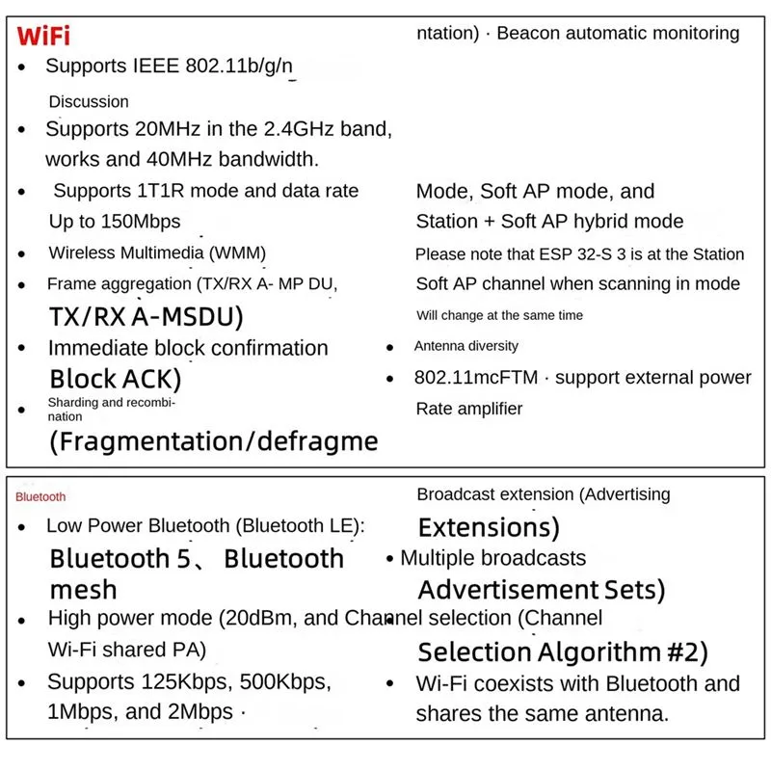
CAD/3D/electronic/ep32 rar/6879005999.webp
