JB153486/Proyecto-Balanc-n-Inteligente-II/CAD/3D/electronic/ep32 rar/ESP32-S3-WROOM-1-2.JPG

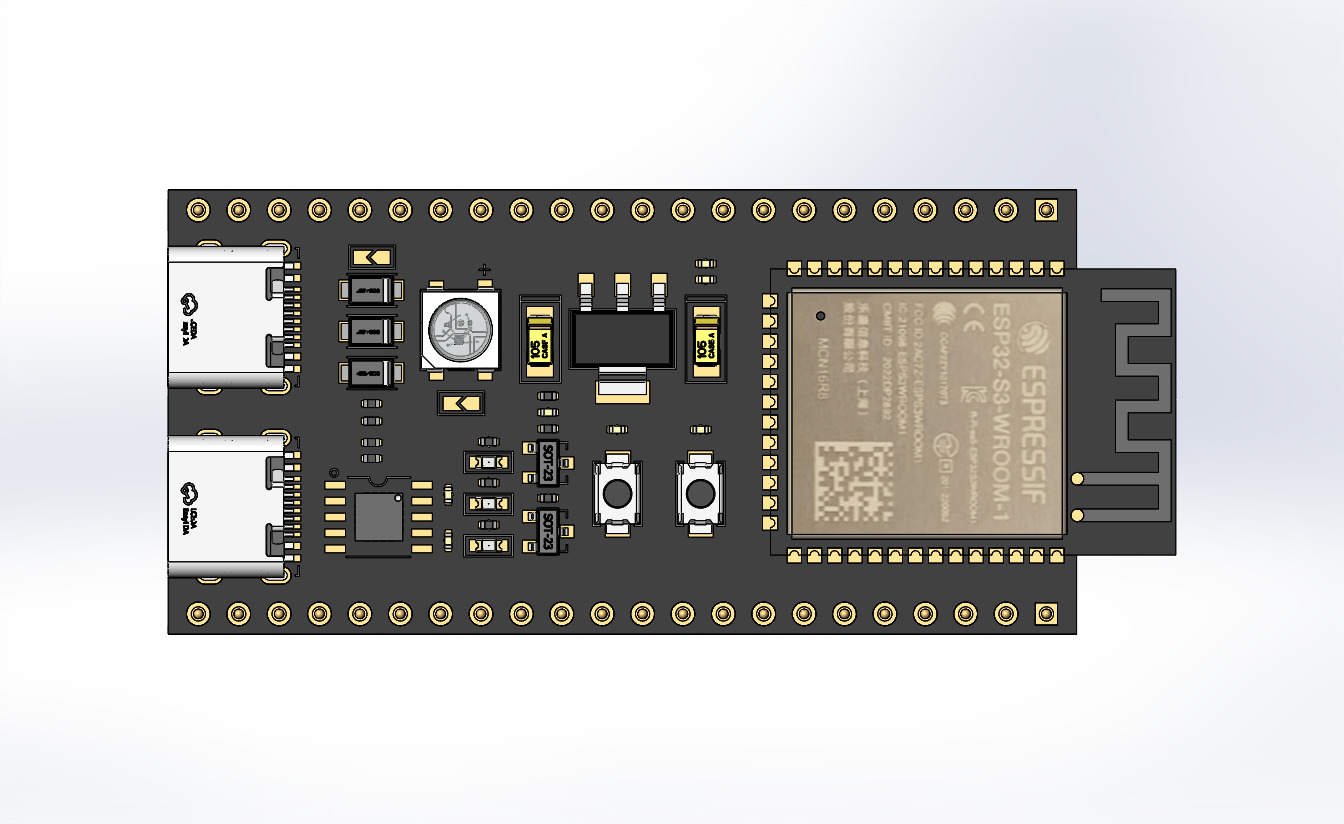
CAD/3D/electronic/ep32 rar/ESP32-S3-WROOM-1-2.JPG
