JB153486/Proyecto-Balanc-n-Inteligente-II/CAD/3D/electronic/ep32 rar/IMG_20260222_004332.png

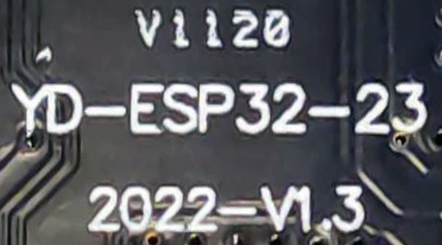
CAD/3D/electronic/ep32 rar/IMG_20260222_004332.png
