JB153486/Proyecto-Balanc-n-Inteligente-II/CAD/3D/electronic/lm5296/LM2596.png

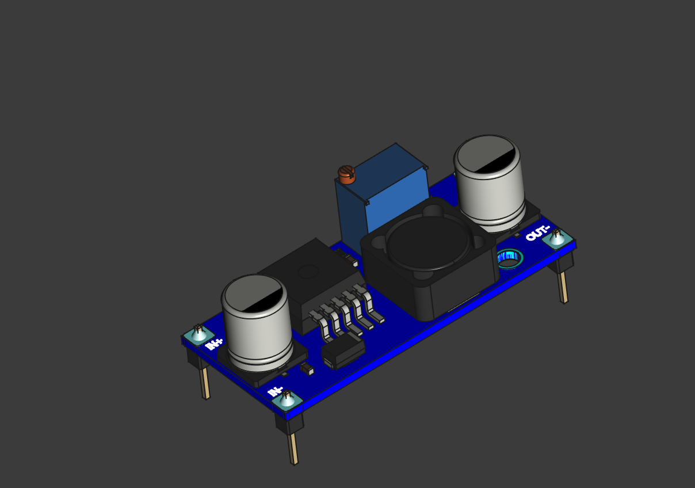
CAD/3D/electronic/lm5296/LM2596.png
