JB153486/Proyecto-Balanc-n-Inteligente-II/CAD/IMAGENES/Captura_1.PNG

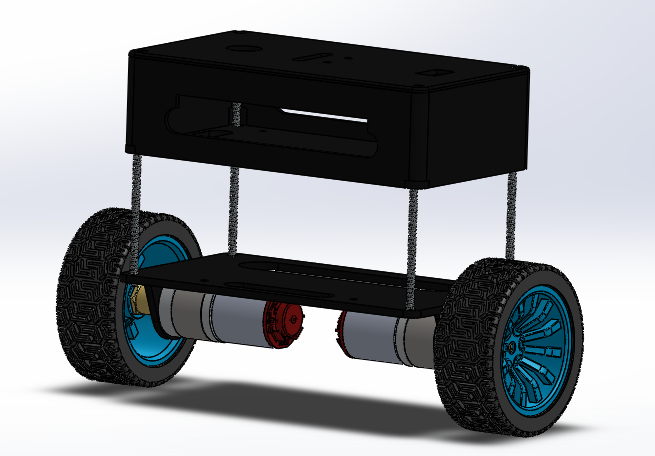
CAD/IMAGENES/Captura_1.PNG
