JB153486/Proyecto-Balanc-n-Inteligente-II/CAD/3D/electronic/tb6612fng/Solidworks 2022/TB6612FNG.SLDASM

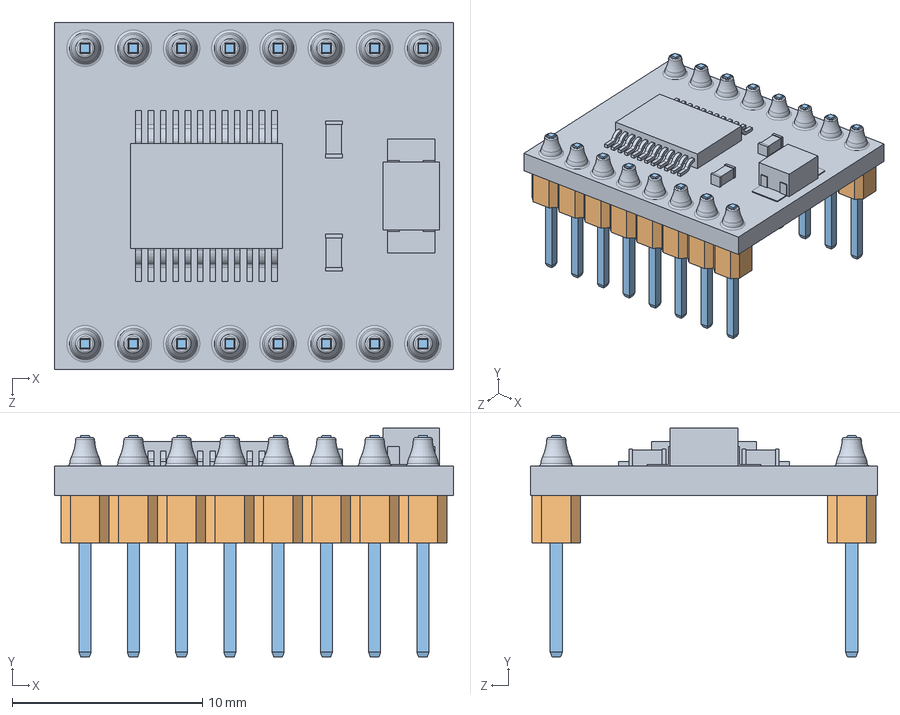
[picture p52: CAD file, 2026-09-23]
CAD/3D/electronic/tb6612fng/Solidworks 2022/TB6612FNG.SLDASM
21.0 x 12.1 x 18.2 mm
Base
Основание пина x 16
Пин x 16
