JB153486/Proyecto-Balanc-n-Inteligente-II/CAD/3D/bae_linea_qtr.SLDPRT

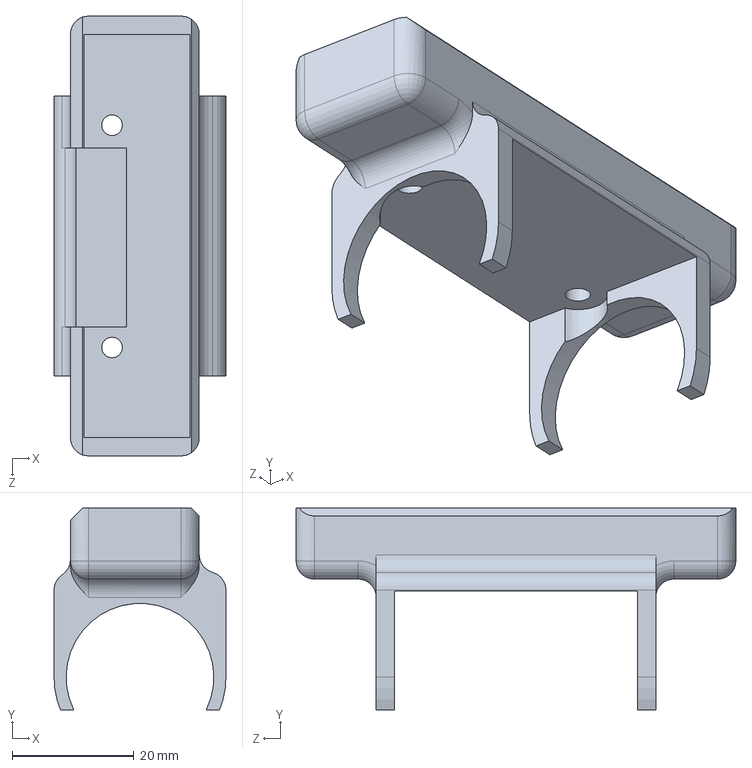
[picture p53: CAD file, 2026-09-23]
CAD/3D/bae_linea_qtr.SLDPRT
28.3 x 33.2 x 72.4 mm
