JB153486/Proyecto-Balanc-n-Inteligente-II/CAD/3D/electronic/lm5296/LM2596.step

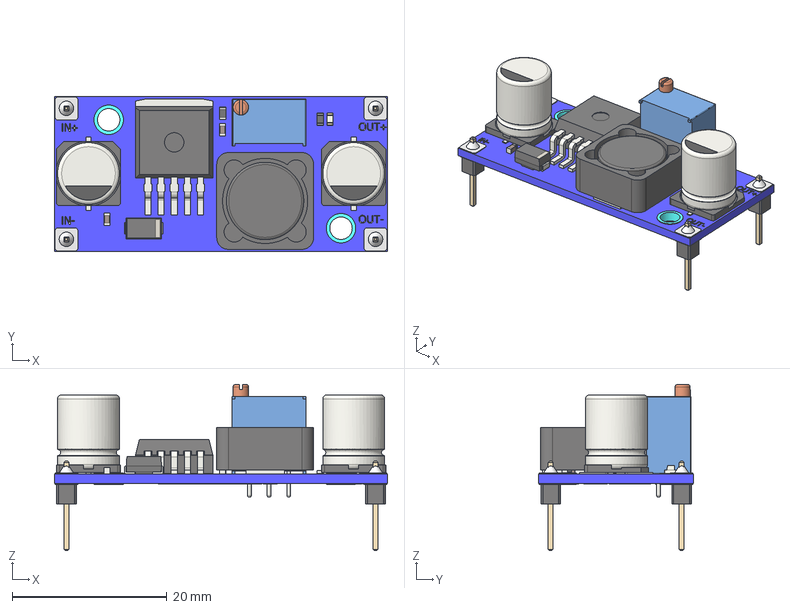
[picture p55: CAD file, 2026-09-23]
CAD/3D/electronic/lm5296/LM2596.step
43.0 x 20.0 x 21.4 mm
C_Elec_8x102
C_Elec_8x103
C_Elec_8x106
C_Elec_8x107
C_0603_1608Metric
C_0603_1608Metric001
D_SMA
a648ce37-9c39-11ed-93f0-dde97e994e83_part
a648ce38-9c39-11ed-93f0-dde97e994e83_part
a648ce39-9c39-11ed-93f0-dde97e994e83_part
a648ce39-9c39-11ed-93f0-dde97e994e83_part001
a648ce39-9c39-11ed-93f0-dde97e994e83_part002
a648ce39-9c39-11ed-93f0-dde97e994e83_part003
a648ce39-9c39-11ed-93f0-dde97e994e83_part004
R_0603_1608Metric
SRR1260
Bourns_3299W
R_0603_1608Metric001
LED_0603_1608Metric
PinHeader_1x01_P254mm_Vertical
PinHeader_1x01_P254mm_Vertical001
PinHeader_1x01_P254mm_Vertical002
PinHeader_1x01_P254mm_Vertical003
