JB153486/Proyecto-Balanc-n-Inteligente-II/CAD/3D/electronic/mpu6050/MPU6050 v2.step

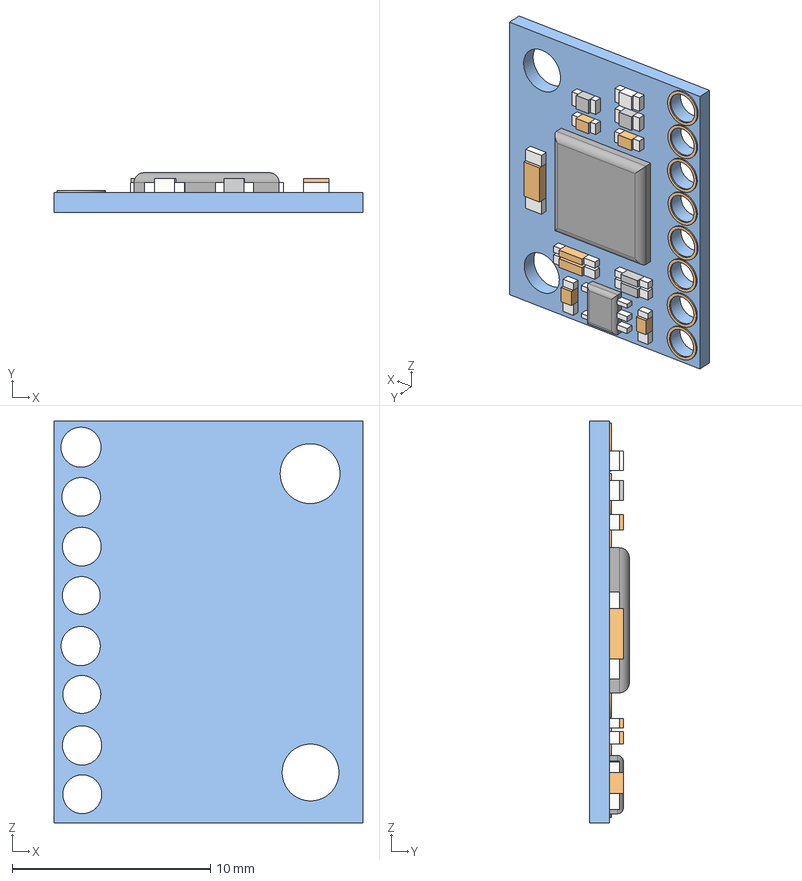
[picture p56: CAD file, 2026-09-23]
CAD/3D/electronic/mpu6050/MPU6050 v2.step
15.6 x 2.00 x 20.3 mm
