JB153486/Proyecto-Balanc-n-Inteligente-II/CAD/3D/electronic/tb6612fng/Solidworks 2022/Пин.SLDPRT

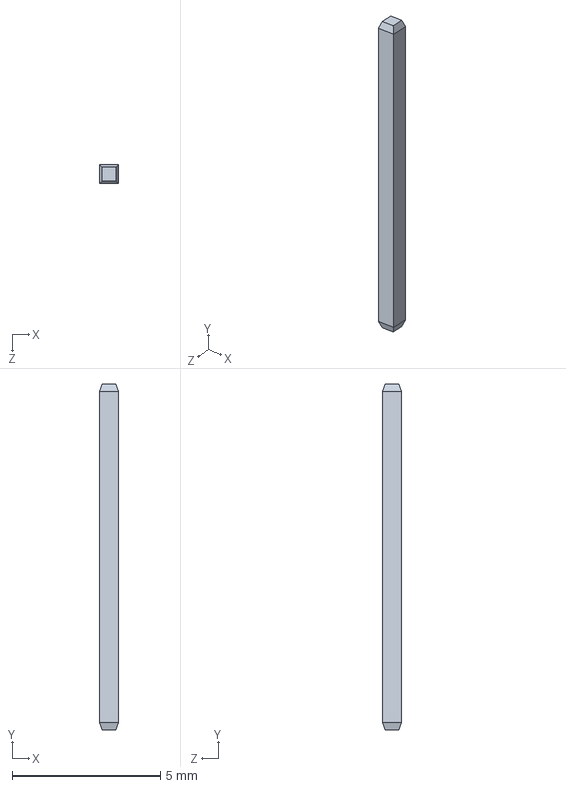
[picture p57: CAD file, 2026-09-23]
CAD/3D/electronic/tb6612fng/Solidworks 2022/Пин.SLDPRT
0.64 x 11.7 x 0.64 mm
