JB153486/Proyecto-Balanc-n-Inteligente-II/CAD/3D/BatteryHolder3S.STEP

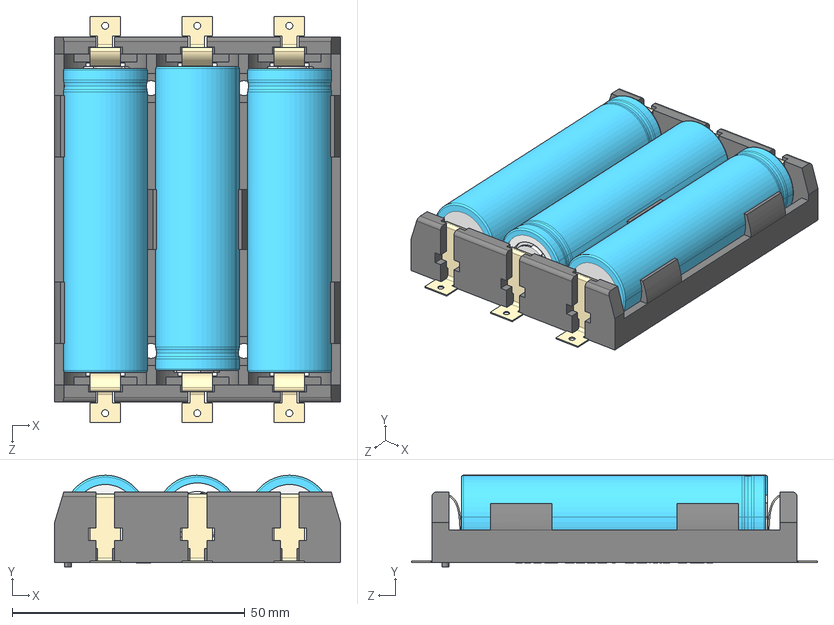
[picture p58: CAD file, 2026-09-23]
CAD/3D/BatteryHolder3S.STEP
61.5 x 19.7 x 87.3 mm
BatteryCasePlastic
BatteryCaseSpring x 6
Battery18650 x 3
