JB153486/Proyecto-Balanc-n-Inteligente-II/CAD/3D/electronic/tb6612fng/Solidworks 2022/Основание пина.SLDPRT

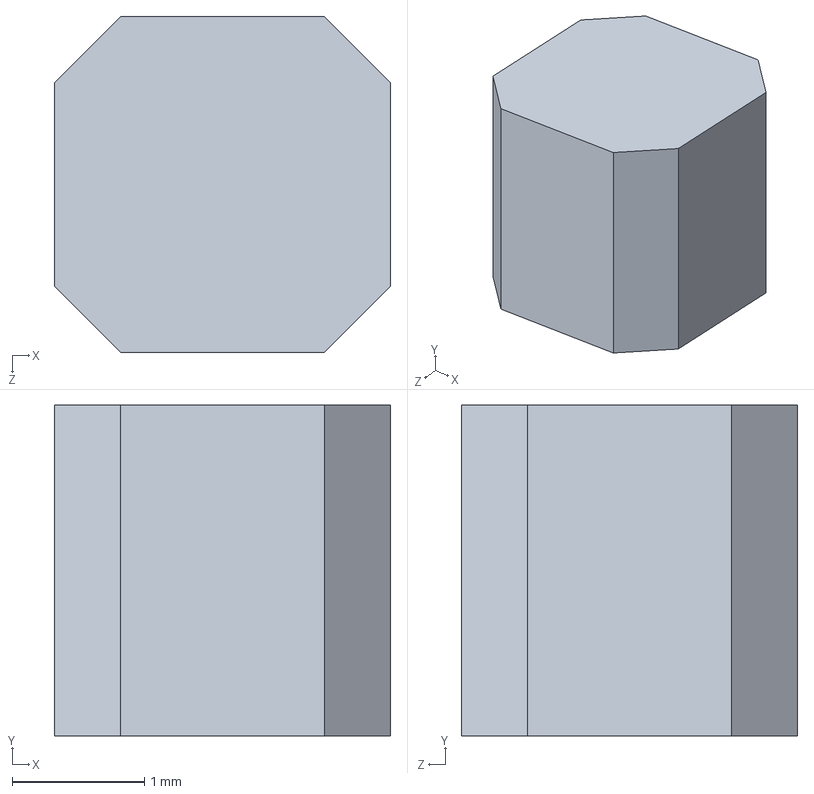
[picture p59: CAD file, 2026-09-23]
CAD/3D/electronic/tb6612fng/Solidworks 2022/Основание пина.SLDPRT
2.54 x 2.50 x 2.54 mm
