JB153486/Proyecto-Balanc-n-Inteligente-II/CAD/3D/electronic/tb6612fng/STEP/TB6612FNG_No Pins.STEP

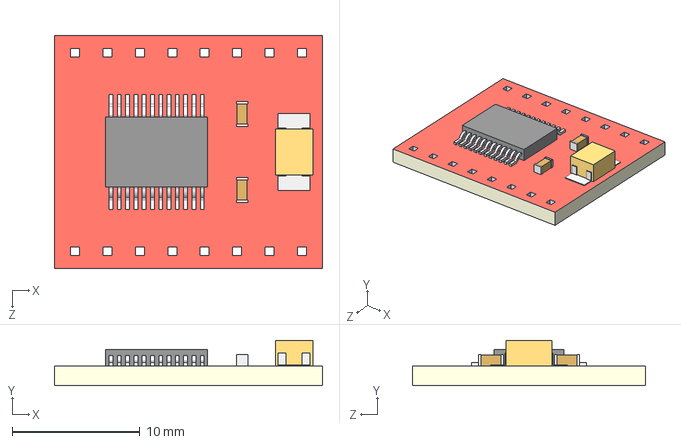
[picture p60: CAD file, 2026-09-23]
CAD/3D/electronic/tb6612fng/STEP/TB6612FNG_No Pins.STEP
21.0 x 3.55 x 18.2 mm
