JB153486/Proyecto-Balanc-n-Inteligente-II/CAD/3D/electronic/ep32 rar/0402_CA_CB_CC_CD.SLDPRT

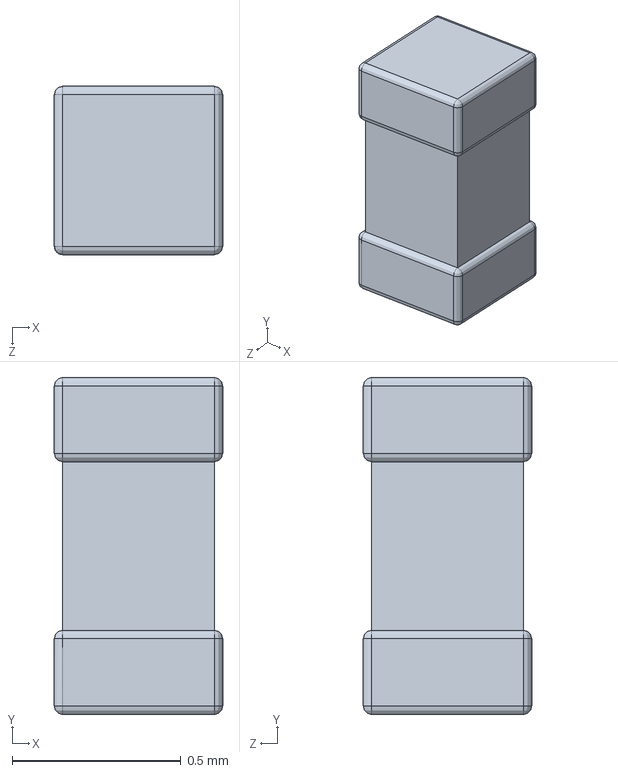
[picture p61: CAD file, 2026-09-23]
CAD/3D/electronic/ep32 rar/0402_CA_CB_CC_CD.SLDPRT
0.5 x 1.00 x 0.5 mm
