JB153486/Proyecto-Balanc-n-Inteligente-II/CAD/3D/QTR-8A_v2.STEP

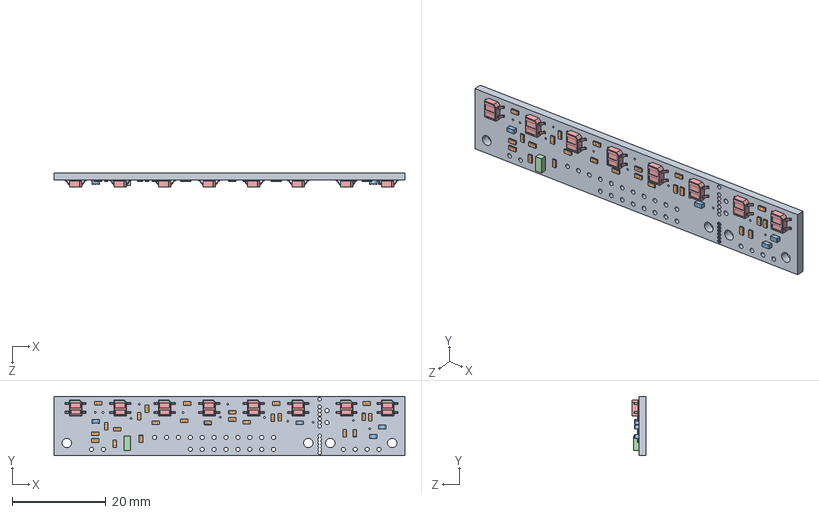
[picture p62: CAD file, 2026-09-23]
CAD/3D/QTR-8A_v2.STEP
74.9 x 12.7 x 3.09 mm
SW3dPS-0603_SMD_Resistor.step x 24
User_Library-User_Library-cap0603_cap0603_body.step x 4
Extruded.step
sop-4-little.step x 8
