JB153486/Proyecto-Balanc-n-Inteligente-II/CAD/3D/motor_balancing.SLDPRT

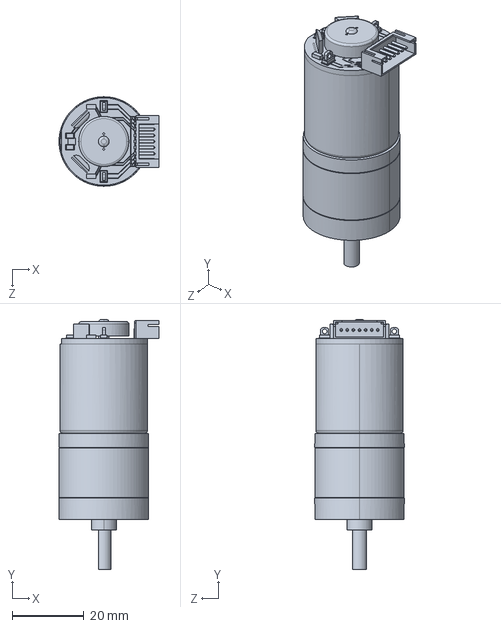
[picture p63: CAD file, 2026-09-23]
CAD/3D/motor_balancing.SLDPRT
27.9 x 69.8 x 25.0 mm
