JB153486/Proyecto-Balanc-n-Inteligente-II/CAD/3D/Tapa_balancing.SLDPRT

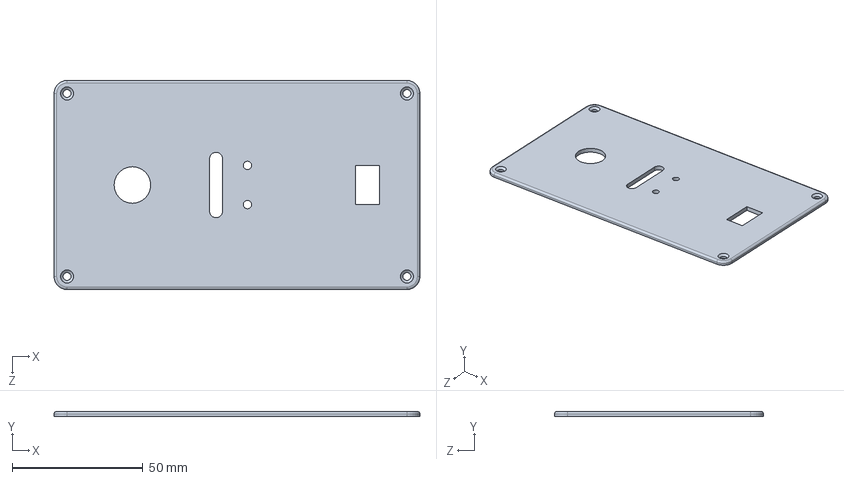
[picture p64: CAD file, 2026-09-23]
CAD/3D/Tapa_balancing.SLDPRT
140.0 x 2.00 x 80.0 mm
