JB153486/Proyecto-Balanc-n-Inteligente-II/CAD/3D/bae_pcb.SLDPRT

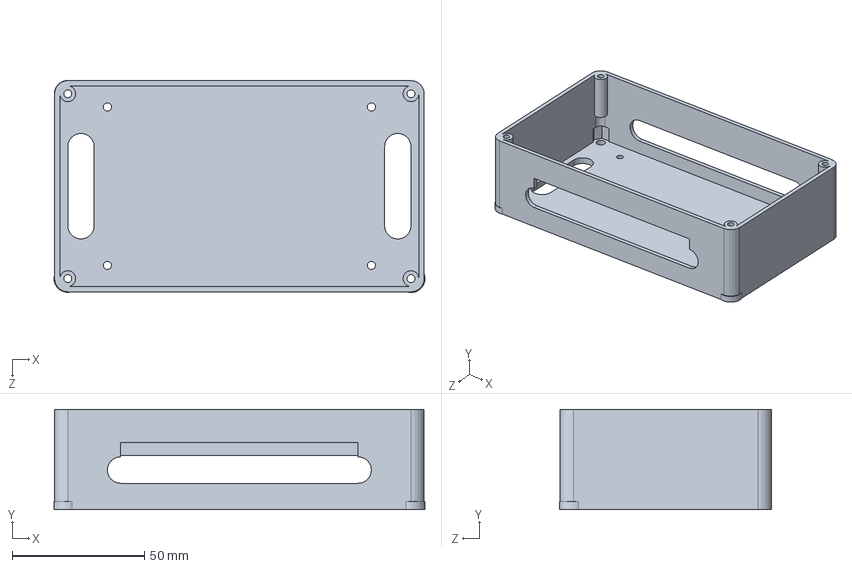
[picture p65: CAD file, 2026-09-23]
CAD/3D/bae_pcb.SLDPRT
140.5 x 38.0 x 80.4 mm
