JB153486/Proyecto-Balanc-n-Inteligente-II/CAD/3D/electronic/ep32 rar/SOT-223.SLDPRT

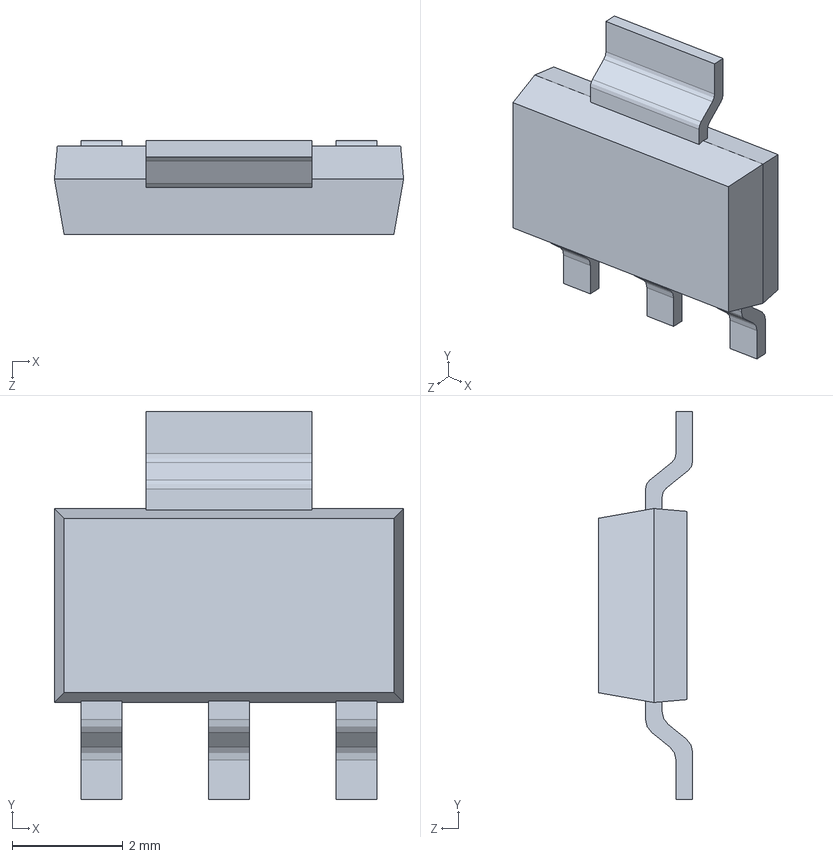
[picture p66: CAD file, 2026-09-23]
CAD/3D/electronic/ep32 rar/SOT-223.SLDPRT
6.30 x 7.00 x 1.70 mm
