JB153486/Proyecto-Balanc-n-Inteligente-II/CAD/3D/bae_motor_bateria.SLDPRT

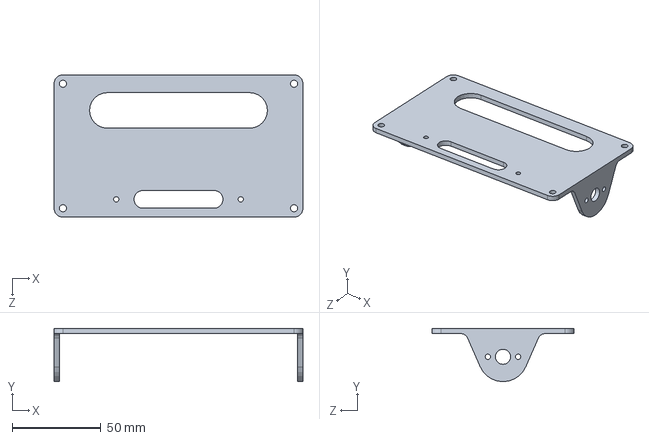
[picture p67: CAD file, 2026-09-23]
CAD/3D/bae_motor_bateria.SLDPRT
140.0 x 30.0 x 80.0 mm
