JB153486/Proyecto-Balanc-n-Inteligente-II/CAD/3D/electronic/ep32 rar/ctantal_case-a_l3-2_w1-6_h1-6.SLDPRT

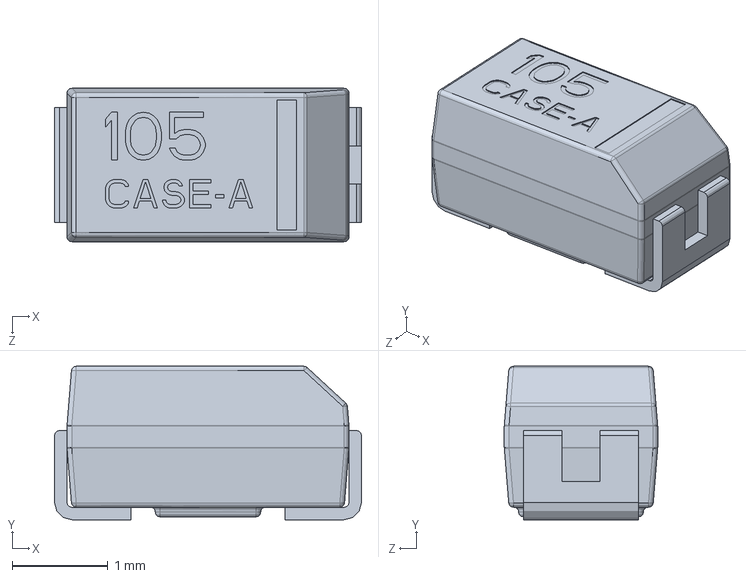
[picture p68: CAD file, 2026-09-23]
CAD/3D/electronic/ep32 rar/ctantal_case-a_l3-2_w1-6_h1-6.SLDPRT
3.20 x 1.60 x 1.60 mm
