JB153486/Proyecto-Balanc-n-Inteligente-II/CAD/3D/electronic/ep32 rar/SOT23-3.SLDPRT

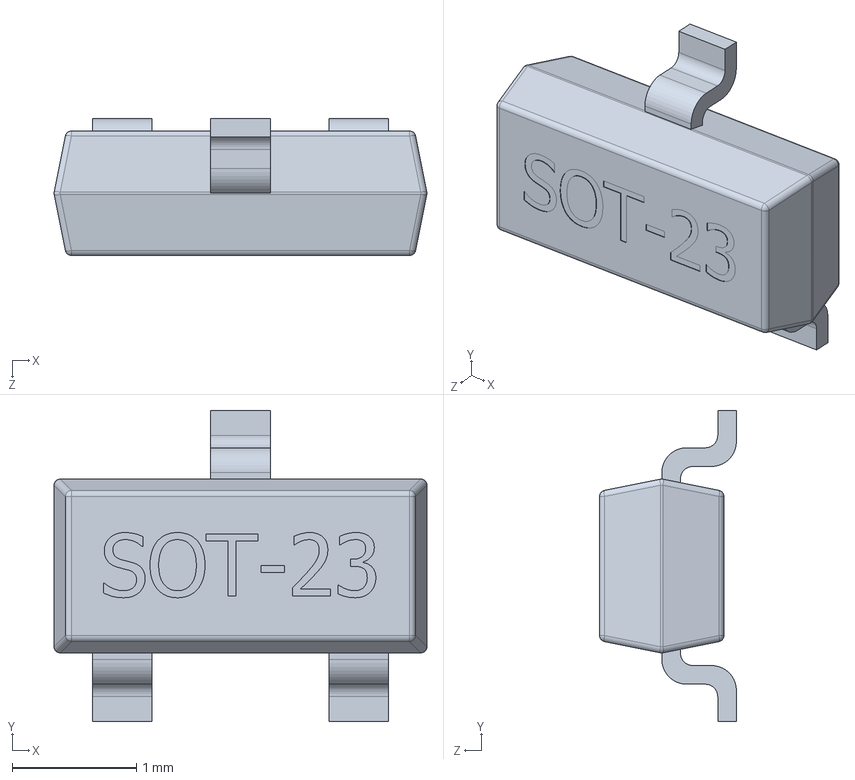
[picture p69: CAD file, 2026-09-23]
CAD/3D/electronic/ep32 rar/SOT23-3.SLDPRT
3.00 x 2.50 x 1.10 mm
