JB153486/Proyecto-Balanc-n-Inteligente-II/CAD/3D/varilla rocada.SLDPRT

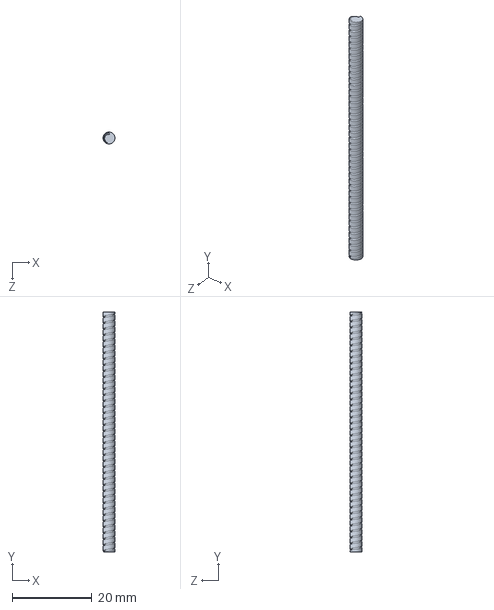
[picture p70: CAD file, 2026-09-23]
CAD/3D/varilla rocada.SLDPRT
3.00 x 60.0 x 3.00 mm
