JB153486/Proyecto-Balanc-n-Inteligente-II/CAD/3D/rueda_motor.SLDPRT

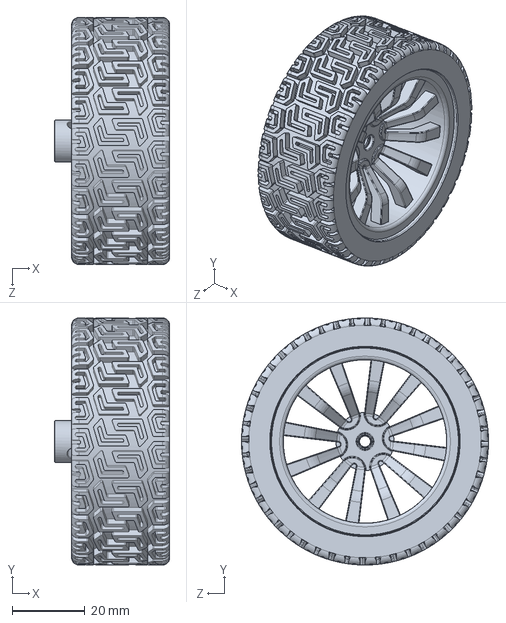
[picture p71: CAD file, 2026-09-23]
CAD/3D/rueda_motor.SLDPRT
31.8 x 68.0 x 68.0 mm
