JB153486/Proyecto-Balanc-n-Inteligente-II/CAD/3D/electronic/ep32 rar/SOD-123F.SLDPRT

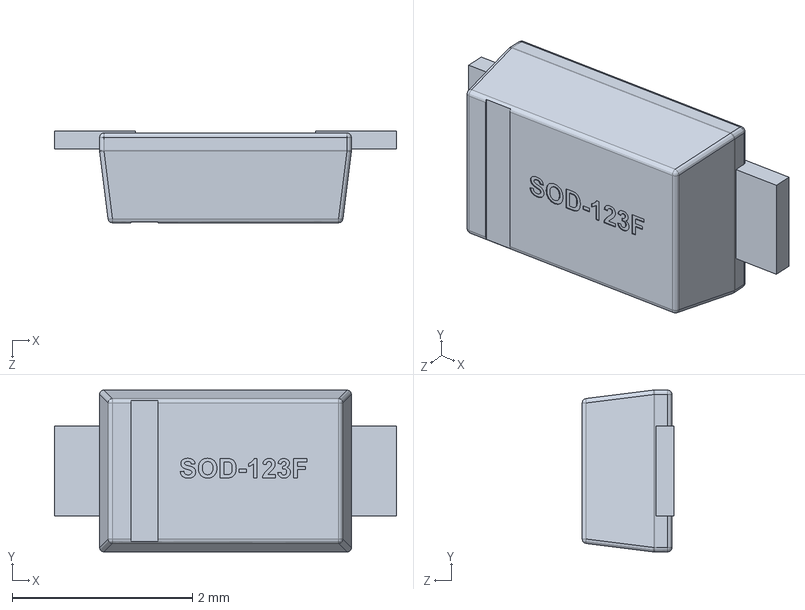
[picture p72: CAD file, 2026-09-23]
CAD/3D/electronic/ep32 rar/SOD-123F.SLDPRT
3.80 x 1.80 x 1.02 mm
