JB153486/Proyecto-Balanc-n-Inteligente-II/CAD/3D/electronic/ep32 rar/WS2812B.SLDPRT

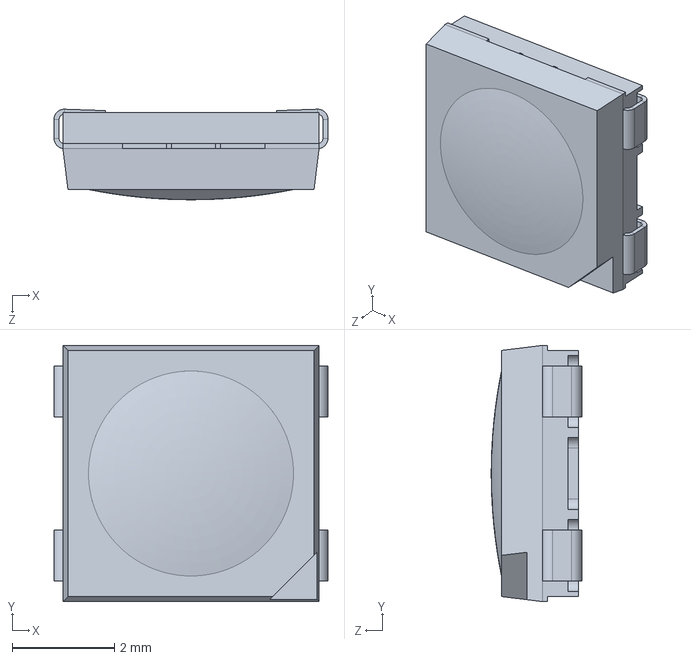
[picture p73: CAD file, 2026-09-23]
CAD/3D/electronic/ep32 rar/WS2812B.SLDPRT
5.35 x 5.00 x 1.77 mm
