JB153486/Proyecto-Balanc-n-Inteligente-II/CAD/3D/electronic/ep32 rar/RC0402.SLDPRT

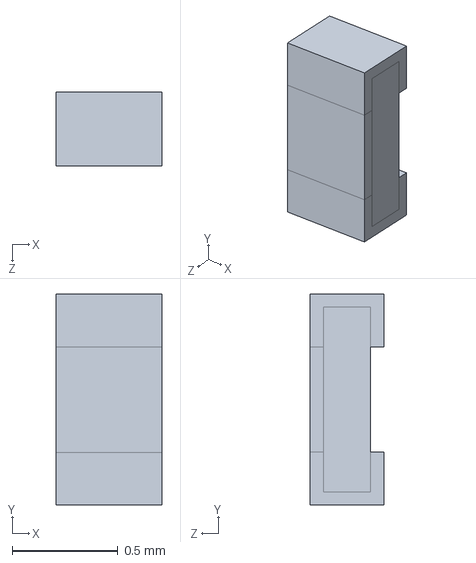
[picture p74: CAD file, 2026-09-23]
CAD/3D/electronic/ep32 rar/RC0402.SLDPRT
0.5 x 1.00 x 0.35 mm
