JB153486/Proyecto-Balanc-n-Inteligente-II/CAD/3D/electronic/ep32 rar/Штыревой разъем 22 конт шаг 2.54мм.SLDPRT

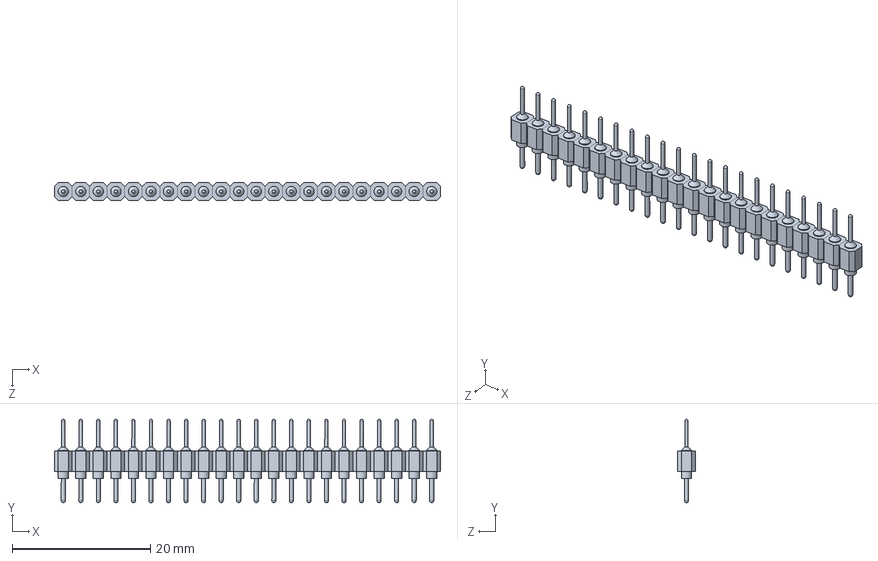
[picture p75: CAD file, 2026-09-23]
CAD/3D/electronic/ep32 rar/Штыревой разъем 22 конт шаг 2.54мм.SLDPRT
55.9 x 12.1 x 2.54 mm
