JB153486/Proyecto-Balanc-n-Inteligente-II/CAD/3D/electronic/ep32 rar/QFN-16 (3x3).SLDASM

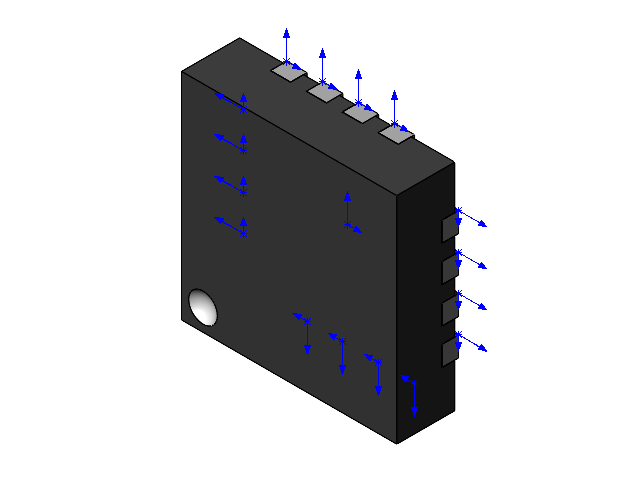
[picture p76: CAD file, 2026-09-23]
CAD/3D/electronic/ep32 rar/QFN-16 (3x3).SLDASM
QFN-16 (3x3) Part1.stp
QFN-16 (3x3) Part2.stp x 16
eBom-FreeParts.stp
