JB153486/Proyecto-Balanc-n-Inteligente-II/CAD/3D/electronic/ep32 rar/LED_0603 v4.SLDASM

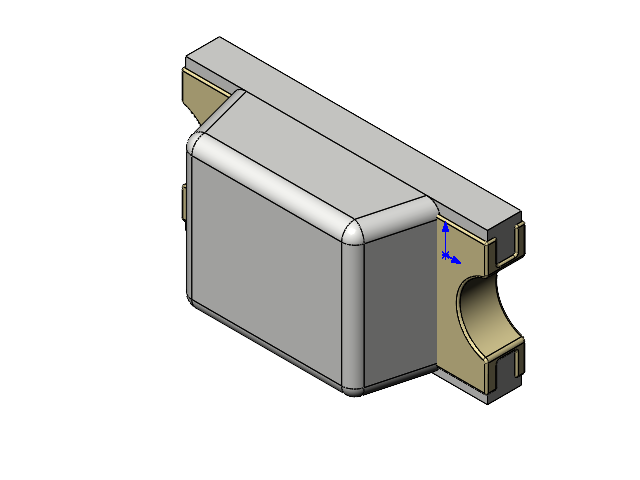
[picture p77: CAD file, 2026-09-23]
CAD/3D/electronic/ep32 rar/LED_0603 v4.SLDASM
Body.step
Cover.step
Cover_Mini.step
Insides.step

CAD/3D/electronic/ep32 rar/sod123 v4.SLDASM
pin.step
pin(Mirror).step
icbody_1.step
Component5.step
