JB153486/Proyecto-Balanc-n-Inteligente-II/(list of files, cad)

Other CAD files:
CAD/3D/electronic/ep32 rar/USB-C.SLDASM
CAD/3D/electronic/ep32 rar/Кнопка.SLDASM
CAD/3D/electronic/tb6612fng/STEP/TB6612FNG_Lower Pins.STEP
CAD/3D/electronic/tb6612fng/STEP/TB6612FNG_Upper Pins.STEP
CAD/3D/electronic/tb6612fng/Solidworks 2022/Base.SLDPRT
CAD/3D/electronic/ep32 rar/ESP32-S3-WROOM-1.SLDASM
CAD/3D/electronic/mpu6050/MPU6050 v2.stl
CAD/3D/electronic/tb6612fng/SLDPRT/TB6612FNG_Lower Pins.SLDPRT
CAD/3D/electronic/tb6612fng/SLDPRT/TB6612FNG_No Pins.SLDPRT
CAD/3D/electronic/tb6612fng/SLDPRT/TB6612FNG_Upper Pins.SLDPRT
