JB153486/Proyecto-Balanc-n-Inteligente-II/(commit log)

2026-09-18 Agrega archivo de prueba a mi rama personal
2026-09-23 LEVANTANDO PUBLICANDO EN NUESTRO REPOSITORIO REMOTO DE GITHUB ALGUNOS DE NUESTROS ARCHIVOS DE CAD
    [0402_CA_CB_CC_CD.SLDPRT, Base.SLDPRT, BatteryHolder3S.STEP, ESP32-S3-WROOM-1.SLDASM, ESP32-S3-WROOM-1.STEP, LED_0603 v4.SLDASM, LM2596.step, MPU6050 v2.step]
2026-09-24 1ra PARTE: PRUEBAS UNITARIAS (MOTORES, ENCODERS, MPU)
    [conection.xlsx]
